JoteraJ/do-an-chuyen-nganh-meshdrone/docs/nhatkylamviec/nhat-ky_2026-09-26_den_2026-09-27.md

# Nhật ký làm việc — 26/09/2026 → 27/09/2026

Đồ án: Mạng WiFi Mesh kết nối Drone/Robot (Đề tài 14)
Folder kiểm tra: `D:\DOAN_CHUYENNGANH_MESH`
Cách lập: so thời gian sửa file trong folder + đọc lịch sử git cục bộ (`.git`), so sánh commit `4a47520` (18/09) với `5bc8f30` (27/09) bằng `git diff`. Chỉ đọc, không ghi gì vào folder.

---

## 1. Tóm tắt nhanh

Trong 2 ngày có **5 file code thay đổi thật** (firmware Root, firmware Leaf/Camera, 2 file `mesh_config.h`, dashboard) — tổng **+1332 / −261 dòng**. Tất cả được gộp vào 1 commit và đã push lên GitHub (`origin/main = 5bc8f30`). Ngoài ra có 1 sửa `.gitignore` **chưa commit**.

Chủ đề chính: **chuẩn bị cho chạy nhiều Leaf cùng lúc (3 Leaf)** — Root ghép được nhiều frame song song, Leaf gửi thẳng về Root thay vì broadcast, và dashboard có tab đo/so sánh 1–2–3 Leaf.

| Thời điểm | File | Loại thay đổi |
|---|---|---|
| 26/09 16:05 | `thuattoan/node_camera/mesh_config.h` | Sửa (+beacon, đổi hằng reassembly) |
| 26/09 16:07 | `thuattoan/node_root/node_root.ino` | Sửa (4 slot, supersede, beacon) |
| 26/09 16:08 | `thuattoan/node_camera/node_camera.ino` | Sửa (sendSingle, học root_id) |
| 26/09 16:09 | `thuattoan/node_root/mesh_config.h` | Sửa (4 slot × 24KB, beacon) |
| 26/09 19:31 | `thuattoan/middleware/public/dashboard.html` | Viết lại gần hết (345 → 1274 dòng) |
| 27/09 21:16–21:17 | git: pull → commit → amend ×2 → push | Xem mục 4 |
| 27/09 21:17 | `prompt_bringup_3_leaf_camera_node.md` | Chỉ đổi thời gian sửa, **nội dung không đổi** (chỉ khác ký tự xuống dòng CRLF) |
| 27/09 22:03 | `.gitignore` | Sửa, **chưa commit** |

Các thư mục còn lại (`baocao/`, `nhatkylamviec/`, `tài liệu/`, `code esp32/`, `thuattoan/shared/`, `thuattoan/esp_idf_migration/`, `middleware/server.js`…) **không có thay đổi** trong khoảng thời gian này.

---

## 2. Firmware — chi tiết thay đổi

### 2.1. Root Node (`node_root.ino` + `node_root/mesh_config.h`)

**Bộ nhớ ghép ảnh (reassembly):**
- `MAX_CONCURRENT_FRAMES`: **1 → 4** slot.
- `MAX_FRAME_SIZE`: **65536 → 24576** byte (24KB); `MAX_CHUNKS_PER_FRAME`: **64 → 24**.
- Tổng buffer: 4 × 24KB = **96KB SRAM** (trước là 1 × 64KB). Ghi chú trong code: Root là ESP32-WROOM-32D **không có PSRAM**, còn khoảng ~120KB SRAM khả dụng.
- Lý do ghi trong code: số slot phải ≥ số Leaf gửi đồng thời + 1, nếu không chunk của Leaf này sẽ đẩy frame đang ghép dở của Leaf kia ra (eviction chéo → drop cao). 4 slot đủ cho 3 Leaf.
- Thêm `#error` kiểm tra lúc biên dịch: `MAX_CHUNKS_PER_FRAME × MAX_CHUNK_PAYLOAD` phải ≥ `MAX_FRAME_SIZE`.
- `REASSEMBLY_TIMEOUT_MS`: **5000 → 2000 ms** (1 frame gửi xong ~0,5s, chờ 5s chỉ giữ slot vô ích).

**Logic ghép mới — "Supersede":**
- Khi chunk của một frame MỚI từ cùng node tới, Root hủy ngay mọi slot đang ghép dở của CÙNG node nhưng khác `frame_id` (vì Leaf gửi tuần tự qua TCP, frame cũ chắc chắn không hoàn thành nữa). Có log `[ASM] SUPERSEDE` và tăng `frames_dropped`.
- Hàm chọn slot cũ nhất để evict: thêm kiểm tra `assemblies[i].active` cho an toàn.

**Beacon Root:**
- Trong `loop()`, cứ `ROOT_BEACON_INTERVAL_MS = 2000 ms` Root phát `mesh.sendBroadcast("#ROOT")`.
- `receivedCallback()` bỏ qua message bắt đầu bằng `#ROOT`. Chọn ký tự `#` vì không thuộc bảng mã Base64 → không nhầm với chunk.

**Giảm log:**
- `mesh.setDebugMsgTypes(ERROR | CONNECTION)` → **`ERROR`** (log painlessMesh chèn vào luồng nhị phân UART 921600 làm middleware phải bỏ byte).
- Thêm cờ `DEBUG_ASM_VERBOSE = 0` để tắt log "bắt đầu ghép / hoàn thành" khi đo hiệu năng.

**Cập nhật chú thích:** thêm cảnh báo — nếu bật lại luồng HTTP MJPEG với nhiều Leaf thì `latest_frame` đang trỏ thẳng vào assembly buffer có thể bị ghi đè; hiện chấp nhận vì HTTP đang tắt.

### 2.2. Leaf / Camera Node (`node_camera.ino` + `node_camera/mesh_config.h`)

**Gửi thẳng về Root thay vì broadcast:**
- Thêm biến `root_id` (mặc định `ROOT_NODE_ID_OVERRIDE = 0` = tự học).
- `receivedCallback()` nay lắng nghe beacon `#ROOT`, gán `root_id = from` và in `[MESH] Root ID = ...`.
- Gửi chunk: `root_id != 0` → `mesh.sendSingle(root_id, ...)`; chưa biết Root → vẫn `sendBroadcast()` làm fallback.
- `changedConnectionCallback()`: nếu Root biến khỏi danh sách node (ví dụ rút nguồn) → reset `root_id` để học lại qua beacon.

**Tiết kiệm tài nguyên:**
- Bước 0 mới trong `capture_and_send()`: nếu chưa biết Root **và** mesh không có node nào → bỏ qua, không chụp (tránh giữ frame buffer duy nhất `CAM_FB_COUNT = 1`).

**Thống kê/log:**
- Thêm bộ đếm `chunks_send_fail`; dòng `[STAT]` in thêm `ChunksFail` và `RootID`.
- Cờ `DEBUG_CAM_VERBOSE = 0` tắt log từng frame; `setDebugMsgTypes` cũng hạ về `ERROR`.

**`mesh_config.h` của Leaf:** các hằng reassembly đổi **khớp với Root** (timeout 2000 ms, 24KB, 24 chunk) để Leaf tự bỏ frame > 24KB trước khi gửi; thêm cùng khối cấu hình beacon (mục 9).

---

## 3. Dashboard (`middleware/public/dashboard.html`)

Viết lại gần như toàn bộ: **345 → 1274 dòng** (diff +1134/−205). Vẫn giữ stack cũ (React 18 + Babel + Tailwind từ CDN, Socket.IO) và cùng 5 sự kiện: `connect`, `disconnect`, `status`, `telemetry`, `frame`.

**Thay đổi chính:**
- Đổi tên hiển thị: "SmartNetworkX" → **"Dashboard Mesh Drone"**; giao diện mới (tông tối zinc, header có badge trạng thái Middleware / Root UART và số LEAF).
- **2 tab:** `Live` và **`So sánh 1/2/3 leaf`**.
- Tab So sánh: mỗi lần nhận telemetry tính tốc độ thay đổi của `frames_ok`, `frames_drop`, `chunks` + số byte JPEG thật nhận qua sự kiện `frame`, rồi xếp mẫu vào nhóm theo `node_count` Root báo. 7 chỉ số: FPS tổng, FPS/leaf, thông lượng ảnh (KB/s), tỉ lệ drop (%), chunk/s tại Root, kích thước frame TB, heap trống tại Root; thêm chỉ số **thời gian self-healing** lấy từ `last_self_heal_ms`.
- Có nút ghi/tạm dừng, reset, biểu đồ cột so sánh, timeline, sparkline, bảng tổng hợp.
- Số liệu tích lũy lưu trong `localStorage` (khóa `meshDashCompare.v1`) → đo lần lượt 1 → 2 → 3 Leaf rồi so sánh, không mất khi tải lại trang.
- Nguyên tắc ghi trong code: **không có dữ liệu giả lập** — chưa có thì hiện "chưa có dữ liệu".
- Hằng tự điền: `HEAP_TOTAL_BYTES`, `PSRAM_TOTAL_BYTES`, `FPS_TARGET` đang để `null`.

Đã đối chiếu: các trường dashboard đọc (`frames_ok`, `frames_drop`, `chunks`, `heap_free`, `psram_free`, `node_count`, `node_ids`, `last_self_heal_ms`) **đều có** trong JSON telemetry mà `node_root.ino` đang gửi.

---

## 4. Git — những gì đã xảy ra tối 27/09

1. **21:16:47** `git pull` — không có gì mới (remote vẫn ở `4a47520`).
2. **21:16:48** commit `b6d75b6` "Them log 2026-09-27" — commit này **vô tình xóa** `prompt_bringup_3_leaf_camera_node.md` (−107 dòng).
3. **21:17:26** `commit --amend` → `5b56776`: thêm lại file prompt (nội dung giống hệt bản cũ).
4. **21:17:33** `commit --amend` lần 2 → `5bc8f30`, đổi message thành **"Cap nhat node_root, node_camera, mesh_config va dashboard"**.
5. **21:17:42** `git push` → GitHub `origin/main = 5bc8f30`.

Kết quả cuối: commit đã push chứa đúng 5 file code ở mục 2–3, file prompt được giữ nguyên.

---

## 5. Việc còn dở / cần lưu ý

1. **`.gitignore` sửa lúc 22:03 chưa commit.** Bản trong git đang ghi sai đường dẫn `thuattoancatanh/middleware/node_modules/` (tên thư mục cũ); bản mới sửa thành `thuattoan/middleware/node_modules/` và thêm `desktop.ini`.
2. **`node_modules` vẫn đang nằm trong git (1206 file).** Sửa `.gitignore` không tự gỡ file đã được theo dõi — cần chạy thêm `git rm -r --cached thuattoan/middleware/node_modules` rồi commit, repo mới hết chứa `node_modules`.
3. **Chưa có file nhật ký mới trong `nhatkylamviec/`** — file gần nhất vẫn là bản 17/09 (commit đầu tiên tên "Them log 2026-09-27" nhưng không thêm file log nào).
4. **Chưa có bằng chứng đã nạp và chạy thử firmware mới trên board** (không có file log/kết quả đo mới trong folder). Khi nạp nên kiểm tra:
   - `heap_free` của Root sau khi khởi động, vì buffer ghép tăng từ 64KB lên 96KB SRAM.
   - Leaf in được `[MESH] Root ID = ...` trong vài giây đầu, và `ChunksFail` trong dòng `[STAT]` gần 0.
   - Log `[ASM] SUPERSEDE` và tỉ lệ drop khi chạy 2–3 Leaf cùng lúc.
5. Dashboard xếp nhóm theo `node_count` = tổng số node trong mesh (trừ Root). Hiện đúng vì mọi node đều là Leaf camera; nếu sau này thêm Parent node không có camera thì số "leaf" sẽ bị đếm dư.
6. Nếu đo nhiều đợt, nhớ bấm reset tab So sánh trước mỗi đợt đo mới, vì số liệu cũ còn lưu trong `localStorage` của trình duyệt.
