JoteraJ/do-an-chuyen-nganh-meshdrone/baocao/DoAn_WiFiMesh_LaTeX/chapters/chuong1.tex

% ================= CHƯƠNG 1 =================
\chapter{GIỚI THIỆU ĐỀ TÀI}\label{chap:1}

Chương này trình bày bối cảnh và lý do lựa chọn đề tài, mục tiêu, nhiệm vụ, đối tượng và phạm vi nghiên cứu, phương pháp thực hiện và bố cục của báo cáo. Các yêu cầu của đề tài được diễn giải thành chức năng, thông số kỹ thuật và giới hạn cụ thể để làm căn cứ đánh giá ở các chương sau. Nội dung của chương là cơ sở để các chương tiếp theo đi vào lý thuyết, thiết kế và kết quả thực nghiệm của hệ thống.

\section{Đặt vấn đề}\label{sec:1.1}

Trong nhiều hệ thống drone và robot hiện nay, các thiết bị kết nối với trạm điều khiển theo mô hình WiFi hình sao (star topology), tức là mọi thiết bị đều phải liên kết trực tiếp với một bộ định tuyến hoặc điểm truy cập trung tâm. Khi thiết bị di chuyển ra xa vùng phủ của bộ định tuyến, hoặc khi bộ định tuyến gặp sự cố, liên kết của thiết bị với trạm bị gián đoạn. Giải pháp thay thế bằng mạng di động 4G đòi hỏi thẻ SIM (Subscriber Identity Module) và hạ tầng nhà mạng, vốn thường không có ở những nơi drone và robot cần làm việc như vùng thiên tai, hầm mỏ hay khu vực rừng núi.

Mạng mesh không dây khắc phục hạn chế này bằng cách cho mỗi node vừa gửi dữ liệu của chính nó vừa chuyển tiếp dữ liệu cho các node lân cận. Nhờ đó, drone hoặc robot nằm ngoài tầm phát trực tiếp của trạm vẫn gửi được dữ liệu qua một chuỗi liên kết đa chặng (multi-hop) \citep{akyildiz2005,bekmezci2013}. Các vi điều khiển tự tạo thành một mạng vô tuyến cục bộ riêng, không cần SIM và không cần Internet. Giả sử một robot hoạt động trong tòa nhà và tường chắn tín hiệu trực tiếp tới trạm; robot vẫn gửi được ảnh nếu có một node trung gian đặt ở hành lang nằm trong tầm phát của cả robot và trạm.

Bài toán đặt ra hai thách thức kỹ thuật chính. Thách thức thứ nhất là định tuyến dữ liệu qua nhiều chặng trong khi topology của mạng thay đổi theo vị trí của các node. Thách thức thứ hai là truyền dữ liệu ảnh có kích thước lớn qua các liên kết vô tuyến có băng thông hạn chế, trong khi mỗi bản tin của thư viện mesh trên ESP32 chỉ mang được khoảng 1400 byte \citep{painlessmesh}.

Đề tài giải quyết bài toán bằng một mạng WiFi Mesh dùng vi điều khiển ESP32 giá thấp và thư viện painlessMesh. Các node lá (Leaf) mang camera đóng vai trò drone hoặc robot thu thập hình ảnh, còn node gốc (Root) nối với máy tính đóng vai trò trạm giám sát. Ảnh định dạng JPEG (Joint Photographic Experts Group) được chia thành nhiều phần nhỏ, truyền qua mạng mesh, ghép lại tại Root và hiển thị trên một giao diện web cùng với các thông số chất lượng mạng.

Về ý nghĩa thực tiễn, đề tài tạo ra một mô hình thử nghiệm giá thấp để đánh giá khả năng truyền ảnh qua mạng mesh trước khi đưa hệ thống lên drone hoặc robot thật. Mô hình phục vụ người phát triển các hệ thống này: thay vì chỉ dựa vào thông số của nhà sản xuất, người phát triển có thể đo trực tiếp thông lượng, số khung trên giây, tỉ lệ hủy khung, độ trễ và thời gian tự phục hồi trên phần cứng thật. Các phép đo ở Chương 4 cho thấy cách mô hình này giúp xác định nút thắt của hệ thống, cụ thể là số vùng đệm ghép ảnh và tải ghi dữ liệu qua giao tiếp nối tiếp UART (Universal Asynchronous Receiver-Transmitter) tại Root.

\section{Mục tiêu của đề tài}\label{sec:1.2}

Mục tiêu của đề tài được xác định ở hai mức. Mục tiêu tổng quát định hướng cho toàn bộ quá trình thực hiện, còn các mục tiêu cụ thể được dùng làm tiêu chí đánh giá kết quả. Các tiêu chí này được định nghĩa thành công thức ở mục~\ref{sec:2.6} và được đo ở Chương 4.

\subsection{Mục tiêu tổng quát}

Mục tiêu tổng quát của đề tài là thiết kế, thi công và đánh giá một mạng WiFi Mesh nhiều node có khả năng truyền ảnh từ các node di động về trạm giám sát theo thời gian thực. Bên cạnh chức năng truyền ảnh, hệ thống phải cung cấp công cụ đo lường để đánh giá chất lượng mạng ngay trong quá trình hoạt động. Các node trong đề tài mô phỏng drone và robot, nên mục tiêu tập trung vào khối truyền thông chứ không vào khối bay hay cơ khí.

\subsection{Mục tiêu cụ thể}

Vì đây là đồ án thuộc chuyên ngành Điện tử – Viễn thông, trọng tâm đánh giá là chất lượng mạng vô tuyến chứ không phải khả năng bay hay cơ khí của drone. Đề tài đặt ra ba tiêu chí đánh giá chính. Tiêu chí thứ nhất là thông lượng (throughput), gồm giá trị thông lượng và mức suy giảm của nó khi dữ liệu đi qua nhiều hop. Tiêu chí thứ hai là độ trễ (latency), tức khoảng thời gian từ lúc chụp ảnh đến lúc ảnh được ghép xong tại trạm giám sát. Tiêu chí thứ ba là thời gian tự phục hồi (self-healing), tức khoảng thời gian mạng khôi phục đường truyền khi một node trung gian mất nguồn hoặc ra khỏi vùng phủ sóng.

\section{Nhiệm vụ của đề tài}\label{sec:1.3}

Để đạt được các mục tiêu trên, yêu cầu của đề tài được diễn giải thành sáu nhóm nhiệm vụ, bao phủ từ nghiên cứu nền tảng phần mềm, phần cứng, cơ chế truyền ảnh, phần mềm trên máy tính đến kịch bản thử nghiệm. Với mỗi nhóm, Bảng~\ref{tab:1.1} nêu chức năng cần đạt, thông số kỹ thuật được chọn và giới hạn trong phạm vi đồ án. Các nhóm nhiệm vụ này cũng quyết định cấu trúc của Chương 3 và Chương 4.

\begin{table}[!htbp]
\centering
\caption{Diễn giải các nhóm nhiệm vụ của đề tài}\label{tab:1.1}
{\fontsize{12}{14.5}\selectfont\renewcommand{\arraystretch}{1.25}
\begin{tabular}{|C{1.10cm}|L{3.40cm}|L{9.30cm}|}
\hline
\textbf{STT} & \textbf{Nhóm nhiệm vụ} & \textbf{Chức năng, thông số và giới hạn} \\
\hline
1 & Nền tảng phần mềm & Tìm hiểu cơ chế tác vụ của FreeRTOS và cách painlessMesh tự tổ chức mạng cây; thiết kế mô hình một Root nhận dữ liệu từ nhiều Leaf. \\
\hline
2 & Phần cứng và nguồn & Một Root ESP32 DevKitC cấp nguồn qua cổng USB (Universal Serial Bus); ba Leaf ESP32-CAM OV3660, mỗi Leaf dùng pin 18650 và module tăng áp 5 V; đo dòng tiêu thụ và đánh giá độ ổn định khi truyền. \\
\hline
3 & Truyền ảnh qua mesh & Chia ảnh JPEG thành chunk tối đa 1024 byte kèm header 16 byte; Root ghép tối đa bốn khung song song và hủy khung thiếu chunk sau 2 giây; chưa có cơ chế gửi lại. \\
\hline
4 & Thu nhận dữ liệu trên máy tính & Root gửi khung nhị phân có mã kiểm tra CRC16 (Cyclic Redundancy Check) qua UART 921600 bps; middleware Node.js phát dữ liệu tới trình duyệt bằng Socket.IO trên nền WebSocket. \\
\hline
5 & Giao diện giám sát & Web Dashboard hiển thị ảnh từng Leaf, topology, cường độ tín hiệu RSSI (Received Signal Strength Indicator), độ trễ, thông lượng, số khung trên giây, tỉ lệ hủy khung và xuất dữ liệu ra tệp CSV (Comma-Separated Values). \\
\hline
6 & Kịch bản thử nghiệm & Thay đổi số Leaf từ một đến ba, số hop và tải dữ liệu qua chu kỳ chụp 300 ms hoặc 600 ms; đánh giá thông lượng, độ trễ, tỉ lệ hủy khung, khả năng tự phục hồi và khả năng mở rộng. \\
\hline
\end{tabular}}
\end{table}

\section{Đối tượng và phạm vi nghiên cứu}

Mục này xác định đối tượng mà đề tài tập trung nghiên cứu và giới hạn phạm vi thực hiện. Đối tượng và phạm vi này là cơ sở để xây dựng các kịch bản thử nghiệm được trình bày ở Chương 4. Những nội dung nằm ngoài phạm vi được nêu rõ để tránh mở rộng nhận xét vượt quá điều kiện đã thử nghiệm.

\subsection{Đối tượng nghiên cứu}

Đối tượng nghiên cứu là mạng mesh WiFi tạo bởi các vi điều khiển ESP32 sử dụng thư viện painlessMesh, cùng cơ chế truyền ảnh JPEG qua mạng này. Phần cứng thử nghiệm gồm một Root dùng board ESP32-WROOM-32D DevKitC và ba Leaf dùng board ESP32-CAM với camera OV3660. Các node sử dụng anten mạch in PCB (Printed Circuit Board) tích hợp sẵn trên board, không sử dụng anten rời.

\subsection{Phạm vi nghiên cứu}

Đề tài không chế tạo khung drone hay robot. Chuyển động của drone được mô phỏng bằng cách cầm tay hoặc đặt các node ở những vị trí cố định khác nhau trên mặt đất, không sử dụng xe điều khiển từ xa. Ba Leaf có cấu hình phần cứng giống nhau; vai trò chuyển tiếp không gắn với một phần cứng riêng mà do mạng tự hình thành tùy theo vị trí và cường độ tín hiệu tại thời điểm thử nghiệm. Với một Root và ba Leaf, mạng có thể tạo chuỗi tối đa ba hop để đo thông lượng và độ trễ theo số hop.

\section{Phương pháp thực hiện}

Đề tài được thực hiện theo phương pháp lặp. Sau khi nghiên cứu cơ sở lý thuyết, đề tài xây dựng firmware và phần mềm, rồi đưa từng board vào hoạt động (bring-up). Tiếp theo, hệ thống được thử nghiệm với số node tăng dần và số liệu được thu thập bằng Web Dashboard; mỗi khi xảy ra lỗi, nguyên nhân được chẩn đoán, khắc phục và hệ thống được đo lại.

Về công cụ, firmware được phát triển trên môi trường lập trình Arduino IDE (Integrated Development Environment) 2.3.10 với gói board esp32 của Espressif phiên bản 2.0.17, được hạ từ phiên bản 3.3.11 theo khuyến nghị của painlessMesh, và thư viện Alteriom/painlessMesh 2.0.3. Phần mềm trên máy tính sử dụng Node.js, giao diện giám sát sử dụng React và Tailwind CSS. Mã nguồn được quản lý bằng Git trên GitHub.

Trong quá trình thực hiện, đề tài từng thử nghiệm song song một phiên bản dùng giao diện lập trình API (Application Programming Interface) ESP-WIFI-MESH chính thức của Espressif trên nền ESP-IDF (Espressif IoT Development Framework). Ngày 29/09/2026, đề tài chốt sử dụng painlessMesh làm phiên bản chính thức vì danh sách nhiệm vụ đã xác định rõ giao thức này. Phiên bản ESP-IDF được giữ lại và đưa vào hướng phát triển ở Chương 5.

\section{Bố cục báo cáo}\label{sec:1.6}

Báo cáo được tổ chức thành năm chương, đi từ yêu cầu của đề tài tới lý thuyết, thiết kế, kết quả đo và kết luận. Chương 1 giới thiệu bài toán, mục tiêu, nhiệm vụ, đối tượng, phạm vi và phương pháp thực hiện. Chương 2 trình bày cơ sở lý thuyết về mạng mesh không dây, các giao thức định tuyến, mạng ad-hoc cho thiết bị bay, ESP-WIFI-MESH và painlessMesh, FreeRTOS trên ESP32, nền tảng phần cứng và các chỉ số đánh giá hiệu năng mạng.

Dựa trên các cơ sở đó, Chương 3 trình bày thiết kế hệ thống theo thứ tự từ sơ đồ khối tổng thể tới phần cứng các node, firmware trên mạng mesh và phần mềm trên máy tính gồm giao thức UART, middleware và Web Dashboard. Chương 4 trình bày quá trình thử nghiệm, kết quả đo và các nhận xét rút ra từ số liệu. Cuối cùng, Chương 5 tổng kết các kết quả đạt được, các hạn chế và hướng phát triển của đề tài.

\section{Kết luận chương}

Chương 1 đã xác định bài toán liên lạc cho drone và robot khi không có hạ tầng mạng cố định và đề xuất hướng giải quyết bằng mạng WiFi Mesh dùng ESP32. Các yêu cầu của đề tài đã được diễn giải thành sáu nhóm nhiệm vụ với thông số và giới hạn cụ thể, cùng phạm vi thử nghiệm trên mặt đất với một Root và ba Leaf. Chương 2 tiếp theo trình bày cơ sở lý thuyết làm nền cho thiết kế và đánh giá hệ thống.
