JoteraJ/do-an-chuyen-nganh-meshdrone/baocao/DoAn_WiFiMesh_LaTeX/frontmatter/biachinh.tex

% ================= BÌA CHÍNH =================
\begin{titlepage}
\centering
\fontsize{14}{17}\selectfont
TỔNG LIÊN ĐOÀN LAO ĐỘNG VIỆT NAM\\
\textbf{TRƯỜNG ĐẠI HỌC TÔN ĐỨC THẮNG}\\
\textbf{KHOA ĐIỆN – ĐIỆN TỬ}\\[1.2cm]
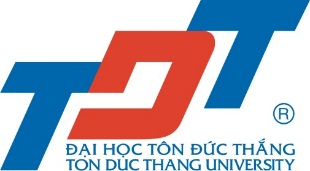
[picture p1: baocao/DoAn_WiFiMesh_LaTeX/figures/logo_tdtu.jpg]
\\[1.5cm]
\textbf{\tensinhvien}\\[2.2cm]
{\fontsize{24}{30}\selectfont\bfseries \tendetai\par}
\vspace{2.2cm}
{\fontsize{22}{28}\selectfont\bfseries \loaidoan\\[0.3cm] \nganh\par}
\vfill
\textbf{THÀNH PHỐ HỒ CHÍ MINH, NĂM \namthuchien}
\end{titlepage}
