JoteraJ/do-an-chuyen-nganh-meshdrone/baocao/DoAn_WiFiMesh_LaTeX/frontmatter/biaphu.tex

% ================= BÌA PHỤ =================
\begin{titlepage}
\centering
\fontsize{14}{17}\selectfont
TỔNG LIÊN ĐOÀN LAO ĐỘNG VIỆT NAM\\
\textbf{TRƯỜNG ĐẠI HỌC TÔN ĐỨC THẮNG}\\
\textbf{KHOA ĐIỆN – ĐIỆN TỬ}\\[1.2cm]
\\[1.5cm]
\textbf{\tensinhvien}\\[0.3cm]
MSSV: \mssv\\[1.9cm]
{\fontsize{22}{28}\selectfont\bfseries \tendetaidongmot\\ \tendetaidonghai\par}
\vspace{1.8cm}
{\fontsize{20}{26}\selectfont\bfseries \loaidoan\\[0.3cm] \nganh\par}
\vspace{1.5cm}
Người hướng dẫn\\
\textbf{\gvhd}
\vfill
\textbf{THÀNH PHỐ HỒ CHÍ MINH, NĂM \namthuchien}
\end{titlepage}
\setcounter{page}{3}
