JoteraJ/do-an-chuyen-nganh-meshdrone/baocao/DoAn_WiFiMesh_LaTeX/frontmatter/loicamon.tex

% ================= LỜI CẢM ƠN =================
\chapter*{LỜI CẢM ƠN}
Tôi xin chân thành cảm ơn \gvhd{} đã tận tình hướng dẫn, góp ý và định hướng cho tôi trong suốt quá trình thực hiện đồ án. Tôi cũng xin cảm ơn quý thầy cô Khoa Điện – Điện tử, Trường Đại học Tôn Đức Thắng đã truyền đạt những kiến thức nền tảng về điện tử, viễn thông và mạng máy tính, giúp tôi có cơ sở để hoàn thành đề tài này. Cuối cùng, tôi xin cảm ơn gia đình và bạn bè đã luôn động viên, hỗ trợ tôi trong thời gian qua.

\vspace{1cm}
\hfill\begin{minipage}{0.55\textwidth}\centering
\textit{\ngayky}\\
\textit{Tác giả}\\[2cm]
\textit{\tensinhvienthuong}
\end{minipage}
