JoteraJ/do-an-chuyen-nganh-meshdrone/baocao/DoAn_WiFiMesh_LaTeX/frontmatter/viettat.tex

% ================= DANH MỤC CHỮ VIẾT TẮT =================
% Sắp theo thứ tự ABC; gồm cả các chữ viết tắt xuất hiện ở Chương 4.
\chapter*{DANH MỤC CÁC CHỮ VIẾT TẮT}
\phantomsection\addcontentsline{toc}{chapter}{DANH MỤC CÁC CHỮ VIẾT TẮT}
\begin{longtable}{@{}p{3.2cm}p{11.8cm}@{}}
AGPS & Assisted Global Positioning System \\
AODV & Ad hoc On-Demand Distance Vector \\
AP & Access Point \\
API & Application Programming Interface \\
B.A.T.M.A.N & Better Approach To Mobile Ad-hoc Networking \\
COM & Communication port \\
CPU & Central Processing Unit \\
CRC & Cyclic Redundancy Check \\
CSMA/CA & Carrier Sense Multiple Access with Collision Avoidance \\
CSV & Comma-Separated Values \\
DC & Direct Current \\
DGPS & Differential Global Positioning System \\
DSDV & Destination-Sequenced Distance Vector \\
DSR & Dynamic Source Routing \\
ELP & Echo Location Protocol \\
ESP-IDF & Espressif IoT Development Framework \\
FANET & Flying Ad-hoc Network \\
FPS & Frames Per Second \\
GPS & Global Positioning System \\
GPSR & Greedy Perimeter Stateless Routing \\
ID & Identifier \\
IDE & Integrated Development Environment \\
IMU & Inertial Measurement Unit \\
IoT & Internet of Things \\
IP & Internet Protocol \\
IWDT & Interrupt Watchdog Timer \\
JPEG & Joint Photographic Experts Group \\
JSON & JavaScript Object Notation \\
LoS & Line of Sight \\
LRU & Least Recently Used \\
lwIP & Lightweight IP \\
MANET & Mobile Ad-hoc Network \\
NACK & Negative Acknowledgement \\
OGM & Originator Message \\
OLSR & Optimized Link State Routing \\
OTA & Over-The-Air \\
PCB & Printed Circuit Board \\
PSRAM & Pseudo-Static Random Access Memory \\
RFC & Request for Comments \\
RSSI & Received Signal Strength Indicator \\
RTOS & Real-Time Operating System \\
SIM & Subscriber Identity Module \\
SMP & Symmetric Multiprocessing \\
SoC & System on Chip \\
SPI & Serial Peripheral Interface \\
SPIFFS & SPI Flash File System \\
SRAM & Static Random Access Memory \\
STA & Station \\
STT & Số thứ tự \\
SVG & Scalable Vector Graphics \\
TBRPF & Topology Broadcast based on Reverse-Path Forwarding \\
TCP & Transmission Control Protocol \\
TQ & Transmit Quality \\
TWDT & Task Watchdog Timer \\
TX & Transmit \\
UART & Universal Asynchronous Receiver-Transmitter \\
UAV & Unmanned Aerial Vehicle \\
USB & Universal Serial Bus \\
UTC & Coordinated Universal Time \\
UWB & Ultra-Wideband \\
VANET & Vehicular Ad-hoc Network \\
WMN & Wireless Mesh Network \\
\end{longtable}
