JoteraJ/do-an-chuyen-nganh-meshdrone/baocao/tiến độ/Bao_cao_50_WiFi_Mesh.pptx

BÁO CÁO TIẾN ĐỘ 50%

Mạng WiFi Mesh
cho Drone / Robot

Truyền ảnh ESP32-CAM qua mesh đa chặng — Đề tài 14

Nguyễn Dương Hiếu

Notes: Mở đầu: đồ án xây mạng WiFi mesh tự tổ chức giữa các ESP32-CAM, ảnh đi đa chặng về Root rồi lên PC. Nguồn: claude_trang-thai-hien-tai.md.

## Slide 2

Mục tiêu: 3 tiêu chí đánh giá

Throughput

Lượng ảnh qua mesh
theo số node / số hop

Latency

Độ trễ từ lúc chụp
đến lúc tới Root

Self-healing

Thời gian mạng tự
phục hồi khi mất node

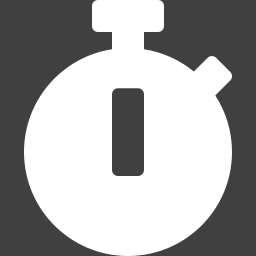
[picture p3: figure]

Yêu cầu đề bài: ESP-Mesh hoặc BATMAN-adv

Notes: 3 tiêu chí hội đồng chấm: throughput, latency, self-healing — đo trên mesh nội bộ (2026-09-13_middleware-test-wifi-debug.md). Đề bài: "ESP-Mesh hoặc BATMAN-adv"; BATMAN-adv là module kernel Linux nên không chạy trên ESP32 (claude_migration-esp-wifi-mesh.md).

## Slide 3

Sơ đồ khối hệ thống

Leaf ×3

ESP32-CAM
OV3660

Root

ESP32
WROOM-32D

Middleware

Node.js
PC

Dashboard

Web
localhost:3000


WiFi Mesh


UART
921600


Socket.IO


Lớp 1 · Mesh không dây

Lớp 2 · UART nhị phân + CRC16

Lớp 3 · Middleware + Dashboard

Notes: Kiến trúc 3 lớp: Leaf → mesh → Root → UART 921600 → middleware Node.js → Socket.IO → dashboard (claude_trang-thai-hien-tai.md; claude_2026-09-18_bao-cao-tien-do-va-kiem-tra-source-code.md hình 1). Root: ESP32-32D DevKitC, CP2102, không PSRAM (2026-09-12_root-node-bringup.md). Leaf: ESP32-CAM OV3660, CH340 (2026-09-14_leaf-bringup-mesh-fix.md). Thư viện: Alteriom/painlessMesh.

## Slide 4

Cấu trúc mạng: cây mesh động

ROOT

Layer 0

Mỗi node: AP + STA
cùng lúc

Parent tự bầu
theo RSSI

Layer 1

Leaf A

Leaf B

B tự làm Parent
(relay cho C)

Đường dự phòng
khi B mất

Tối đa 3 hop
với 3 Leaf

Layer 2

Leaf C

Notes: ESP32 vừa là station nối lên cha vừa là AP cho con → cây nhiều lớp (tài_liệu, Phần 3.1). Không có node Parent riêng về phần cứng; vai trò tự bầu theo RSSI, 3 node di động + Root dựng được chuỗi tối đa 3 hop (claude_trang-thai-hien-tai.md). Node cha hỏng → con tự chọn cha mới, có thể thêm 1 lớp (tài_liệu, Phần 3.2). Lưu ý: hình minh họa nguyên lý; test 17/09 thực tế 2 Leaf nối trực tiếp 1 hop.

## Slide 5

Lưu đồ Leaf: chụp và gửi ảnh

Mesh có
node?

Ảnh
> 24 KB?

Bắt đầu

Có

Chụp JPEG

Có

Bỏ khung

Không

Chờ, không chụp

Không

Đã biết
Root ID?

Cắt chunk 1024 B
+ header 12 B

sendBroadcast()

Không

Mã hóa Base64

Có

sendSingle(Root)

↻ lặp lại cho khung tiếp theo

Root ID học từ beacon
“#ROOT” mỗi 2 giây

Notes: Lưu đồ capture_and_send() bản 26/09: bỏ qua nếu chưa có mesh; khung > 24KB bị bỏ; chunk 1024B + header 12B; Base64 vì painlessMesh chỉ nhận String; sendSingle tới root_id học qua beacon #ROOT mỗi 2000ms, chưa biết Root thì sendBroadcast (nhat-ky_2026-09-26_den_2026-09-27.md; claude_migration-esp-wifi-mesh.md; claude_trang-thai-hien-tai.md).

## Slide 6

Lưu đồ Root: ghép ảnh từ nhiều Leaf

Beacon
#ROOT?

Khung mới
cùng node?

Nhận chunk

Không

Tìm slot theo
(node, frame)

Có

Hủy khung
cũ

Có

Bỏ qua

Không

Gửi ảnh lên PC
qua UART

Đủ chunk?

Ghi chunk
+ đánh bitmap

Có

Không

Hủy, drop +1

Có

Quá 2 s?

Không

Chờ chunk tiếp

4 slot
× 24 KB

Notes: Root bản 26/09: bỏ qua message #ROOT; 4 slot ghép song song (4×24KB = 96KB SRAM); supersede: khung mới cùng node → hủy khung cũ đang ghép dở; bitmap đánh dấu chunk; timeout 2000ms; ghép xong gửi khung UART TYPE 0x01 (nhat-ky_2026-09-26_den_2026-09-27.md; claude_2026-09-18_bao-cao-tien-do-va-kiem-tra-source-code.md). Code đã push, chưa nạp board.

## Slide 7

Cấu trúc gói tin

Gói chunk trên mesh

Header
12 B

ID node · ID khung · …

Payload JPEG ≤ 1024 B

→ mã hóa Base64 rồi gửi qua painlessMesh

Khung UART Root → PC

MAGIC

TYPE

LEN

DATA

CRC16

TYPE 0x01 = ảnh đã ghép · telemetry JSON mỗi 2 s

Notes: Chunk 1024B + header 12B (claude_trang-thai-hien-tai.md; claude_2026-09-18...). Base64 vì painlessMesh chỉ nhận String (claude_migration-esp-wifi-mesh.md). Khung UART MAGIC+TYPE+LEN+CRC16, TYPE 0x01 = ảnh đã ghép, telemetry JSON mỗi 2s (claude_trang-thai-hien-tai.md; 2026-09-12_root-node-bringup.md). Kích thước từng trường của khung UART: không tìm thấy trong tài liệu hiện có.

## Slide 8

Làm sao biết node đang ở trong mesh?

Kiểm chứng qua 4 tầng, từ node đến màn hình

1

2

3

4

Leaf

Root ID = …

Root

node_ids có ID Leaf

PC /status

ảnh từ nodeId Leaf

Dashboard

ảnh “vừa xong”

Ảnh vẫn tới PC
= dữ liệu đã đi qua mesh


Leaf chỉ cắm nguồn

không dây dữ liệu nối PC

Notes: Trả lời: 1) Serial Leaf: [MESH] Node ID, Found 1 nodes ESP32_MESH_VIDEO -57dBm, [MESH] Root ID = ..., [STAT] ChunksFail ~0 (2026-09-14_leaf-bringup-mesh-fix.md; nhat-ky_2026-09-26_den_2026-09-27.md). 2) Telemetry Root mỗi 2s: node_count, node_ids từ bảng node mesh. 3) /status: latestFrameMeta.nodeId, framesBadCrc ~0. 4) Dashboard: badge LEAF, ảnh "vừa xong"; cẩn thận ảnh cũ kèm "X giây trước". Bằng chứng mạnh nhất: Leaf chỉ cấp nguồn vẫn gửi ảnh được — đã xác nhận 17/09 (claude_2026-09-17_multi-leaf-throughput-diagnosis-selfhealing-plan.md). Số liệu 14/09: node_count 1, node_ids [1207449329], frames_ok 1306. Giới hạn: danh sách node phẳng, chưa có quan hệ cha/con nên chưa hiển thị số hop.

## Slide 9

Kiểm chứng ngược: rút nguồn một Leaf

Rút nguồn
Leaf

node_count
giảm

Cấp nguồn
lại

node_count
tăng

Ghi last_self_heal_ms

Notes: Quy trình 6 bước: rút nguồn 1 Leaf, theo dõi node_count giảm rồi tăng, đọc last_self_heal_ms, lặp 3–5 lần (claude_2026-09-17_multi-leaf-throughput-diagnosis-selfhealing-plan.md). 3 mẫu thô 885/10461/32528 ms — phân tán lớn, chưa dùng làm kết quả chính thức, cần ≥5 mẫu (2026-09-16_leaf-bringup-rf-diagnosis-power-plan.md; claude_2026-09-18...). Mới đo được kiểu tái kết nối, chưa đo đổi tuyến qua node trung gian.

## Slide 10

Kết quả đo: tỉ lệ mất khung ảnh

Nguyên nhân

Leaf A

Leaf B

Root: 1 slot

A và B đẩy khung của nhau ra

Đã sửa: 4 slot × 24 KB

Chưa nạp board, chưa đo lại

Notes: 1 Leaf: 1306 OK / 6 drop ~0,5% (2026-09-14_leaf-bringup-mesh-fix.md). 2 Leaf: 111 OK / 496 drop ~82% (claude_2026-09-17_multi-leaf...). UART sạch: 5 sai CRC / 16069 khung (~0,03%). Nguyên nhân: Root chỉ 1 slot ghép → eviction chéo; giả thuyết FrameAssembler ở middleware đã được đính chính là sai (claude_2026-09-18...). Sửa lên 4 slot trong code 26/09, chưa đo lại (nhat-ky_2026-09-26_den_2026-09-27.md).

## Slide 11

Tiến độ đã thực hiện

01/09

Chọn hướng
ESP-Mesh

12/09

Root
chạy thật

14/09

Leaf 1
ổn định

17/09

2 Leaf
đồng thời

27/09

Firmware
nhiều Leaf

10/09

Middleware
+ giao thức UART

13/09

Root → PC
thông suốt

16/09

Nạp
Leaf 2, 3

18/09

Tìm ra
lỗi drop

Notes: Mốc: 01/09 quyết định ESP-WIFI-MESH, giữ painlessMesh dự phòng (claude_migration-esp-wifi-mesh.md); 10/09 middleware + UART_PROTOCOL (claude_trang-thai-hien-tai.md); 12/09 bring-up Root (2026-09-12...); 13/09 khép kín Root→middleware (2026-09-13...); 14/09 Leaf 1 ổn định (2026-09-14...); 16/09 Leaf 2,3 + tranh chấp RF (2026-09-16...); 17/09 2 Leaf đồng thời (claude_2026-09-17...); 18/09 tìm nguyên nhân drop (claude_2026-09-18...); 26–27/09 firmware nhiều Leaf + dashboard mới, commit 5bc8f30 (nhat-ky_2026-09-26...). Tỉ lệ % hoàn thành cụ thể: không tìm thấy trong tài liệu hiện có.

## Slide 12

Trạng thái và bước tiếp theo

Throughput

Có số liệu 1–2 Leaf

Chưa đo theo hop

Tiếp theo

Latency

Chưa đo được

Header chưa có mốc thời gian

Self-healing

3 mẫu thô

Cần ≥ 5 mẫu

Nạp firmware
mới, đo lại

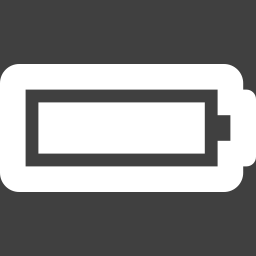
[picture p10: figure]

Hàn nguồn
pin 18650


Đo 1 / 2 / 3
hop

Đo self-healing
≥ 5 lần

Notes: Throughput: có drop rate 1–2 Leaf, chưa theo hop. Latency: bản painlessMesh không đo được vì header 12B không mang mốc thời gian chụp; chỉ bản ESP-IDF có capture_ts_ms. Self-healing: 3 mẫu phân tán (claude_2026-09-18_bao-cao-tien-do-va-kiem-tra-source-code.md). Việc tiếp theo theo thứ tự ưu tiên: nạp firmware 26/09 kiểm tra heap_free, Root ID, ChunksFail; hàn 3 bộ nguồn pin (việc chặn đường lớn nhất); bố trí Root→Relay→Leaf xa đo 1/2/3 hop; đo self-healing ≥5 lần; hỏi giảng viên về ESP-IDF vs painlessMesh (claude_2026-09-18...; nhat-ky_2026-09-26...).

## Slide 13

Cảm ơn thầy/cô
đã lắng nghe

Hỏi & đáp
