JoteraJ/do-an-chuyen-nganh-meshdrone/baocao/tiến độ/Tong_hop_bao_cao_50_WiFi_Mesh.docx

BÁO CÁO TIẾN ĐỘ 50%

Đồ án chuyên ngành mạng — Đề tài 14

Mạng WiFi Mesh kết nối Drone/Robot truyền ảnh ESP32-CAM

Sinh viên: Nguyễn Dương Hiếu — Tài liệu tổng hợp chuẩn bị báo cáo, cập nhật 27/09/2026

Cách đọc tài liệu này

Mọi thông tin quan trọng đều ghi rõ file nguồn trong dấu ngoặc (ví dụ (theo nhat-ky_2026-09-26_den_2026-09-27.md)). Khi hai file mâu thuẫn, tài liệu dùng file có ngày mới hơn và ghi chú ở Mục 7. Chỗ nào tài liệu dự án không có thông tin thì ghi rõ "không tìm thấy trong tài liệu hiện có".

Phần trả lời câu hỏi "Làm sao biết node đang hoạt động trong mạng mesh?" nằm ở Mục 3, có kèm câu trả lời mẫu để nói trước hội đồng và kịch bản demo.

# 1. Đồ án đang làm gì

Đồ án xây dựng một mạng WiFi mesh tự tổ chức giữa các module ESP32-CAM gắn trên drone/robot. Mỗi node di động chụp ảnh JPEG, cắt ảnh thành các gói nhỏ và gửi qua mesh về một node gốc (Root). Root ghép lại ảnh hoàn chỉnh, đẩy ảnh và số liệu trạng thái qua cổng UART lên máy tính, nơi một middleware Node.js chuyển tiếp dữ liệu tới dashboard web để hiển thị trực tiếp (theo claude_trang-thai-hien-tai.md).

Ba tiêu chí hội đồng dùng để đánh giá là throughput, latency và self-healing; cả ba đều được đo trên mesh nội bộ giữa các ESP32, không phụ thuộc việc Root có nối WiFi router hay không (theo 2026-09-13_middleware-test-wifi-debug.md). Đề bài yêu cầu cấu hình giao thức "ESP-Mesh hoặc BATMAN-adv"; BATMAN-adv bị loại vì là module kernel Linux, không chạy được trên ESP32 (FreeRTOS) (theo claude_migration-esp-wifi-mesh.md).

Quyết định kiến trúc quan trọng: không có node "Parent/Robot" riêng về phần cứng. Vai trò Leaf/Parent được tự bầu động theo RSSI lúc chạy, nên với 3 node di động + 1 Root vẫn dựng được chuỗi tối đa 3 hop (theo claude_trang-thai-hien-tai.md).

## 1.1 Phần cứng và phần mềm đang dùng thực tế

Thành phần | Thông số / trạng thái | Nguồn
Root Node | ESP32-32D DevKitC TypeC, lõi WROOM-32, chip USB-Serial CP2102 (COM7), không có PSRAM, UART 921600 baud | 2026-09-12_root-node-bringup.md
Leaf Node ×3 | ESP32-CAM camera OV3660, anten PCB, đế nạp USB tích hợp chip CH340, PSRAM ~4MB; Serial Monitor 115200 baud. Mua Shopee SAMIORE (thay đơn Tuyết Nga đã hủy) | 2026-09-14_leaf-bringup-mesh-fix.md
Thư viện mesh | Fork Alteriom/painlessMesh 2.0.3 (bản gốc dính bug scan GitLab #275) | 2026-09-14… ; 2026-09-16…
Core Arduino | esp32 by Espressif 2.0.17 (hạ từ 3.3.11) | 2026-09-13_middleware-test-wifi-debug.md
Tên mạng mesh | SSID ESP32_MESH_VIDEO, mật khẩu phải giống nhau ở mọi node | 2026-09-13_middleware-test-wifi-debug.md
Nguồn di động | Pin 18650 + đế pin + boost 5V (ngõ ra USB-A) + tụ 470uF; quy trình hàn 8 bước đã soạn, chưa hàn | 2026-09-16_leaf-bringup-rf-diagnosis-power-plan.md
PC | Middleware Node.js (Express + Socket.IO), dashboard React tại http://localhost:3000 | 2026-09-13… ; nhat-ky_2026-09-26…

# 2. Nguyên lý hoạt động

## 2.1 Kiến trúc 3 lớp

Lớp | Chức năng | Thành phần
Lớp 1 — Mesh | Các Leaf chụp ảnh, chia gói, gửi đa chặng về Root qua WiFi mesh | ESP32-CAM ×3 + Root, painlessMesh
Lớp 2 — UART | Root gửi ảnh đã ghép + telemetry + log lên PC theo khung nhị phân có CRC16 | Root → cáp USB (CP2102) → PC, 921600 baud
Lớp 3 — Ứng dụng | Middleware tách khung, phát sự kiện Socket.IO; dashboard hiển thị ảnh, số node, số liệu đo | Node.js + dashboard HTML/React

Kiến trúc này mô tả trong (theo claude_trang-thai-hien-tai.md) và hình 1 của bộ báo cáo 18/09 (theo claude_2026-09-18_bao-cao-tien-do-va-kiem-tra-source-code.md).

## 2.2 Mạng mesh hình thành như thế nào

Nền tảng là khả năng AP-STA đồng thời của chip ESP32: một node vừa là station kết nối lên node cha, vừa là access point nhận kết nối từ node con. Nhờ đó mạng hình thành topology dạng cây nhiều lớp (Root/Parent/Leaf) và truyền được đa chặng mà không cần router (theo tài_liệu, Phần 3.1). Khi khởi động, Leaf quét tìm mạng có SSID mesh; log thực tế ghi nhận Leaf tìm thấy Root (Found 1 nodes, ESP32_MESH_VIDEO, -57dBm) rồi gọi connectToAP() (theo 2026-09-14_leaf-bringup-mesh-fix.md).

Khi một node cha trung gian hỏng, các node con thử kết nối lại, sau đó tự chọn node cha mới trong tầm phủ sóng; mạng có thể phải thêm một lớp, khiến số hop và độ trễ tăng. Đây là cơ chế self-healing (theo tài_liệu, Phần 3.2). Firmware Root đo thời gian phục hồi qua hai callback onDroppedConnection và onChangedConnections, báo về bằng trường last_self_heal_ms (theo claude_trang-thai-hien-tai.md).

## 2.3 Luồng truyền một khung ảnh (firmware bản 27/09)

1. Chụp ảnh tại Leaf. Camera OV3660 chụp JPEG. Nếu chưa biết Root và mesh không có node nào thì bỏ qua, không chụp; khung lớn hơn 24KB bị Leaf tự loại trước khi gửi (theo nhat-ky_2026-09-26_den_2026-09-27.md).
2. Chia gói. Ảnh được cắt thành các chunk 1024 byte, mỗi chunk có header 12 byte mang thông tin phân biệt node gửi và khung (theo claude_trang-thai-hien-tai.md) (theo claude_2026-09-18_bao-cao-tien-do-va-kiem-tra-source-code.md); bản triển khai thật đã xác nhận có trường node ID (theo claude_2026-09-17_multi-leaf-throughput-diagnosis-selfhealing-plan.md).
3. Mã hóa Base64. painlessMesh chỉ nhận String nên dữ liệu nhị phân phải mã hóa Base64 (tăng ~33% dữ liệu) (theo claude_migration-esp-wifi-mesh.md).
4. Gửi thẳng về Root. Root phát beacon #ROOT mỗi 2000 ms; Leaf nghe beacon để học root_id, sau đó gửi bằng mesh.sendSingle(root_id, ...). Chưa biết Root thì tạm dùng sendBroadcast(). Nếu Root biến khỏi danh sách node, Leaf reset root_id và học lại (theo nhat-ky_2026-09-26_den_2026-09-27.md).
5. Ghép ảnh tại Root. Root có 4 slot ghép song song (4 × 24KB = 96KB SRAM), dùng bitmap đánh dấu chunk đã nhận, timeout 2000 ms, và cơ chế "supersede": khi khung mới của cùng node tới thì hủy khung cũ đang ghép dở (theo nhat-ky_2026-09-26_den_2026-09-27.md).
6. Gửi lên PC. Root đóng khung UART gồm MAGIC + TYPE + LEN + CRC16; TYPE = 0x01 là ảnh đã ghép xong, ngoài ra có khung telemetry JSON gửi mỗi 2 giây (theo claude_trang-thai-hien-tai.md) (theo 2026-09-12_root-node-bringup.md) (theo claude_2026-09-18_bao-cao-tien-do-va-kiem-tra-source-code.md).
7. Middleware và dashboard. Middleware tách khung, kiểm CRC, phát 5 sự kiện Socket.IO (connect, disconnect, status, telemetry, frame). Dashboard có tab Live và tab So sánh 1/2/3 leaf, không dùng dữ liệu giả lập (theo nhat-ky_2026-09-26_den_2026-09-27.md).

Mẫu telemetry thật do Root gửi (đo ngày 12/09, khi chưa có Leaf) (theo 2026-09-12_root-node-bringup.md):

{"ts":16000,"role":"root","layer":0,"frames_ok":0,"frames_drop":0,"chunks":0,"heap_free":122636,"psram_free":0,"node_count":0,"node_ids":[],"last_self_heal_ms":-1}

# 3. Làm sao biết node đang hoạt động trong mạng mesh?

Câu trả lời ngắn (nói trước hội đồng)

Em không dựa vào một dấu hiệu duy nhất mà kiểm chứng theo 4 tầng. Thứ nhất, tại chính node: Serial log cho thấy node quét thấy mạng ESP32_MESH_VIDEO, kết nối được và học được ID của Root. Thứ hai, tại Root: mỗi 2 giây Root báo node_count và danh sách node_ids lấy từ bảng node của mesh — ID của Leaf phải xuất hiện trong đó. Thứ ba, tại PC: API /status và dashboard cho biết khung ảnh mới nhất đến từ node ID nào. Thứ tư, và là bằng chứng mạnh nhất: ảnh của Leaf đến được dashboard trong khi Leaf chỉ được cấp nguồn, không có dây dữ liệu nào nối với PC — dữ liệu chỉ có thể đi qua sóng mesh. Cuối cùng, em kiểm chứng ngược bằng cách rút nguồn một Leaf: node_count giảm, cấp nguồn lại thì tăng trở lại và Root ghi thời gian phục hồi.

Cơ sở: (theo 2026-09-14_leaf-bringup-mesh-fix.md) (theo claude_2026-09-17_multi-leaf-throughput-diagnosis-selfhealing-plan.md) (theo nhat-ky_2026-09-26_den_2026-09-27.md).

## 3.1 Bảng kiểm tra theo 4 tầng

Tầng | Xem ở đâu | Dấu hiệu ĐANG trong mesh | Dấu hiệu KHÔNG trong mesh
1. Tại Leaf | Serial Monitor của Leaf (115200 baud) | [MESH] Node ID: ... sau RST; Found 1 nodes, ESP32_MESH_VIDEO, -57dBm rồi connectToAP(); [MESH] Root ID = ... trong vài giây đầu; dòng [STAT] có ChunksFail gần 0 | Mọi chunk báo THAT BAI; lặp connected but unrooted → Found 0 nodes; lỗi stationScan(): scan could not start
2. Tại Root | Telemetry JSON mỗi 2 s | node_count ≥ 1; node_ids chứa đúng ID của Leaf; frames_ok và chunks tăng liên tục | node_count = 0 hoặc dao động 1–2; frames_ok đứng yên
3. Tại PC | http://localhost:3000/status | serialConnected: true; latestFrameMeta.nodeId = ID của Leaf; framesBadCrc ≈ 0 | serialConnected: false (lỗi đường Root–PC, không phải lỗi mesh)
4. Dashboard | Header và tab Live | Badge số LEAF đúng; ảnh từng node báo "vừa xong" | Ảnh đứng yên kèm "X giây trước" tăng dần

Nguồn cho bảng: tầng 1 (theo 2026-09-14_leaf-bringup-mesh-fix.md) (theo 2026-09-16_leaf-bringup-rf-diagnosis-power-plan.md) (theo nhat-ky_2026-09-26_den_2026-09-27.md); tầng 2–3 (theo 2026-09-12_root-node-bringup.md) (theo 2026-09-13_middleware-test-wifi-debug.md) (theo claude_2026-09-17_multi-leaf-throughput-diagnosis-selfhealing-plan.md); tầng 4 (theo nhat-ky_2026-09-26_den_2026-09-27.md).

## 3.2 Số liệu thật đã chứng minh node nằm trong mesh

Ngày 14/09, với 1 Leaf, /status báo node_count: 1, node_ids: [1207449329], frames_ok: 1306, frames_drop: 6 và middleware ghi log ghép ảnh "HOAN THANH" liên tục đúng frame_id, xác nhận dữ liệu ảnh tới nơi nguyên vẹn chứ không chỉ "gửi thành công" ở tầng mesh (theo 2026-09-14_leaf-bringup-mesh-fix.md). Ngày 17/09, với 2 Leaf, node_count: 2 giữ ổn định với hai ID 1207433521 và 1207449329, cả hai cùng gửi ảnh liên tục; buổi đó cũng xác nhận Leaf tham gia mesh hoàn toàn qua sóng WiFi, cáp USB chỉ để cấp nguồn (theo claude_2026-09-17_multi-leaf-throughput-diagnosis-selfhealing-plan.md).

Để đối chiếu đúng node nào là node nào, đọc dòng [MESH] Node ID trên Serial của từng board ngay sau khi nhấn RST. Cách này từng dùng để loại bỏ giả thuyết trùng Node ID: Leaf2 = 1207433521, Leaf3 = 1207369673, Root = 2846999225 (theo 2026-09-16_leaf-bringup-rf-diagnosis-power-plan.md).

## 3.3 Kiểm chứng chủ động bằng self-healing

Quy trình 6 bước đã thiết kế: đánh dấu mốc t0 khi rút nguồn một Leaf, theo dõi node_count giảm rồi tăng lại, đọc last_self_heal_ms trong telemetry, lặp lại 3–5 lần để lấy min/max/trung bình (theo claude_2026-09-17_multi-leaf-throughput-diagnosis-selfhealing-plan.md). Ba mẫu thô đã ghi được là 885 ms, 10461 ms và 32528 ms, còn phân tán quá lớn nên chưa dùng làm kết quả chính thức (theo 2026-09-16_leaf-bringup-rf-diagnosis-power-plan.md) (theo claude_2026-09-18_bao-cao-tien-do-va-kiem-tra-source-code.md).

## 3.4 Giới hạn cần nói thẳng nếu hội đồng hỏi sâu

Thứ nhất, Root hiện chỉ báo danh sách node phẳng lấy từ mesh.getNodeList(), chưa có quan hệ cha/con hay RSSI của từng liên kết. Vì vậy hệ thống chứng minh được node có mặt trong mesh, nhưng dashboard chưa chỉ ra được node đó đi qua mấy hop; hai Leaf trong lần test 17/09 được suy luận là nối trực tiếp 1 hop vào Root dựa trên khoảng cách vật lý (theo claude_trang-thai-hien-tai.md) (theo claude_2026-09-17_multi-leaf-throughput-diagnosis-selfhealing-plan.md). Thứ hai, node_count là tổng số node trong mesh trừ Root, hiện đúng bằng số Leaf vì mọi node đều có camera (theo nhat-ky_2026-09-26_den_2026-09-27.md). Thứ ba, khi node rớt, dashboard vẫn giữ ảnh cuối cùng kèm đồng hồ "X giây trước", dễ gây hiểu nhầm là còn dữ liệu — phải nhìn thời gian cập nhật chứ không chỉ nhìn ảnh (theo claude_2026-09-17_multi-leaf-throughput-diagnosis-selfhealing-plan.md).

## 3.5 Kịch bản demo đề xuất tại buổi báo cáo

1. Cắm Root vào PC, đóng Serial Monitor trước rồi mới chạy node server.js COM7, vì chỉ một chương trình được giữ COM7 tại một thời điểm (theo 2026-09-13_middleware-test-wifi-debug.md).
2. Mở dashboard: lúc chưa có Leaf, badge LEAF = 0 và node_ids rỗng.
3. Cấp nguồn cho một Leaf (chỉ nguồn, không dây dữ liệu). Chờ vài giây: node_count lên 1, ID xuất hiện trong node_ids, ảnh bắt đầu chạy.
4. Mở /status để hội đồng thấy latestFrameMeta.nodeId trùng ID của Leaf.
5. Rút nguồn Leaf: node_count giảm, ảnh chuyển sang "X giây trước". Cấp nguồn lại: node quay lại và last_self_heal_ms được cập nhật.

Lưu ý: firmware bản 27/09 chưa có bằng chứng đã nạp và chạy thử trên board (theo nhat-ky_2026-09-26_den_2026-09-27.md). Nếu demo bằng bản này, nên nạp và kiểm tra trước buổi báo cáo; nếu không kịp, demo bằng bản đã chạy ổn định 1 Leaf (14/09).

# 4. Tiến độ hiện tại

## 4.1 Các mốc đã hoàn thành

Ngày | Việc đã làm | Nguồn
01/09 | Quyết định hướng ESP-WIFI-MESH (ESP-IDF), giữ painlessMesh làm phương án dự phòng; scaffold Phase 1 | claude_migration-esp-wifi-mesh.md
10/09 | Viết UART_PROTOCOL (MAGIC+TYPE+LEN+CRC16), middleware Node.js mới hoàn toàn, test parser 7/7; thêm đo self-healing vào Root | claude_trang-thai-hien-tai.md
12/09 | Bring-up board Root: cài driver CP2102, sửa firmware vì board không có PSRAM; telemetry gửi đều mỗi 2 s | 2026-09-12_root-node-bringup.md
13/09 | Khép kín chuỗi Root → UART → middleware; hạ log painlessMesh, bytesSkipped giảm từ 1.308.534 xuống 1.098 byte | 2026-09-13_middleware-test-wifi-debug.md
14/09 | Leaf #1 chạy ổn định 1 hop sau khi đổi sang fork Alteriom và tắt STA-bridge của Root | 2026-09-14_leaf-bringup-mesh-fix.md
16/09 | Nạp firmware Leaf #2, #3; xác định tranh chấp RF khi đặt Leaf quá gần; 3 mẫu self-healing đầu tiên; soạn quy trình hàn nguồn | 2026-09-16_leaf-bringup-rf-diagnosis-power-plan.md
17/09 | Sửa lỗi dashboard Cannot GET /; chạy được 2 Leaf đồng thời, đo drop rate | claude_2026-09-17_…(2 file)
18/09 | Đọc lại toàn bộ source, tìm ra nguyên nhân drop ~82% (Root chỉ có 1 slot ghép); lập báo cáo tiến độ .docx 21 trang + 7 hình | claude_2026-09-18_bao-cao-tien-do-va-kiem-tra-source-code.md
26–27/09 | Sửa firmware cho nhiều Leaf (4 slot, supersede, beacon Root, sendSingle), viết lại dashboard (345 → 1274 dòng), push commit 5bc8f30 | nhat-ky_2026-09-26_den_2026-09-27.md

## 4.2 Số liệu đã đo được

Phép đo | Kết quả | Nguồn
1 Leaf, 1 hop | frames_ok 1306 / frames_drop 6 → ~0,5% drop | 2026-09-14_leaf-bringup-mesh-fix.md
2 Leaf đồng thời (firmware cũ, 1 slot) | 111 OK / 496 drop → ~82% drop | claude_2026-09-17_multi-leaf…
Đường UART Root–PC | 5 khung sai CRC / 16069 khung OK (~0,03%) | claude_2026-09-17_multi-leaf…
Self-healing (mẫu thô) | 885 ms; 10461 ms; 32528 ms | 2026-09-16_leaf-bringup-rf-diagnosis-power-plan.md
Heap trống tại Root | 122636 byte (~120KB), đo 12/09 | 2026-09-12_root-node-bringup.md

Nguyên nhân drop ~82% khi chạy 2 Leaf: Root chỉ có 1 slot ghép ảnh, nên chunk của Leaf này liên tục đẩy khung đang ghép dở của Leaf kia ra ngoài (eviction chéo). Giả thuyết ngày 17/09 cho rằng lỗi nằm ở "FrameAssembler" của middleware đã được đính chính là sai — middleware không ghép ảnh (theo claude_2026-09-18_bao-cao-tien-do-va-kiem-tra-source-code.md). Bản sửa (4 slot) đã có trong code 26/09 nhưng chưa đo lại (theo nhat-ky_2026-09-26_den_2026-09-27.md).

## 4.3 Trạng thái 3 tiêu chí chấm

Tiêu chí | Trạng thái | Nguồn
Throughput | Có số liệu 1 Leaf và 2 Leaf (drop rate). Chưa đo theo 1/2/3 hop. Dashboard đã có tab so sánh 1/2/3 leaf (FPS, KB/s, drop %, ...) | claude_2026-09-18…; nhat-ky_2026-09-26…
Latency | Chưa đo được trên bản painlessMesh vì header chunk 12 byte không mang mốc thời gian chụp; chỉ bản ESP-IDF có capture_ts_ms | claude_2026-09-18_bao-cao-tien-do-va-kiem-tra-source-code.md
Self-healing | Có 3 mẫu thô, phân tán lớn; mới đo được kiểu "tái kết nối", chưa đo kiểu "đổi tuyến qua node trung gian" vì cần bố trí chuỗi 3 node | claude_2026-09-17_multi-leaf…; claude_2026-09-18…

Về con số "50%": không tìm thấy trong tài liệu hiện có một tỷ lệ phần trăm hoàn thành được tính cụ thể. Các file chỉ liệt kê việc đã xong và việc còn lại như trên.

# 5. Việc còn lại (theo thứ tự ưu tiên)

1. Nạp firmware 26/09, kiểm tra ngay heap_free của Root (buffer tăng từ 64KB lên 96KB SRAM), Leaf in được [MESH] Root ID, ChunksFail gần 0, rồi đo lại drop rate 2–3 Leaf (theo nhat-ky_2026-09-26_den_2026-09-27.md). Nếu thiếu heap thì lùi về 3 slot (theo claude_2026-09-18_bao-cao-tien-do-va-kiem-tra-source-code.md).
2. Hàn 3 bộ nguồn pin 18650 — đây là việc chặn đường lớn nhất, vì còn cắm cáp USB thì không tách node ra xa được (theo claude_2026-09-18_bao-cao-tien-do-va-kiem-tra-source-code.md).
3. Bố trí chuỗi Root → Relay → Leaf xa, đo throughput 1/2/3 hop và self-healing "đổi tuyến" (theo claude_2026-09-17_multi-leaf-throughput-diagnosis-selfhealing-plan.md).
4. Đo self-healing lặp lại ít nhất 5 lần, ghi min/max/trung bình (theo claude_2026-09-18_bao-cao-tien-do-va-kiem-tra-source-code.md).
5. Giải quyết latency: mở rộng header bản painlessMesh hoặc chuyển sang ESP-IDF; hỏi giảng viên xem "ESP-Mesh" có bắt buộc đúng API Espressif không (theo claude_2026-09-18_bao-cao-tien-do-va-kiem-tra-source-code.md) (theo claude_migration-esp-wifi-mesh.md).
6. Bổ sung quan hệ cha/con vào telemetry để dashboard vẽ được cây topology thật (theo claude_2026-09-18_bao-cao-tien-do-va-kiem-tra-source-code.md).
7. Hạng mục đo vùng phủ sóng (RSSI theo khoảng cách) đề bài yêu cầu nhưng chưa có trong kế hoạch (theo claude_migration-esp-wifi-mesh.md).
8. Việc phụ về repo: commit .gitignore đã sửa và gỡ node_modules (1206 file) khỏi git (theo nhat-ky_2026-09-26_den_2026-09-27.md).

# 6. Câu hỏi hội đồng có thể hỏi

Hỏi: Tại sao dùng painlessMesh mà không phải ESP-WIFI-MESH đúng đề bài?

Đáp: Bản painlessMesh là bản "chắc ăn" đã chạy trên board thật. Bản ESP-IDF dùng đúng API esp_mesh đã biên dịch thành công nhưng chưa nạp lên board, ảnh còn giả lập bằng fill_fake_jpeg() (theo claude_2026-09-18_bao-cao-tien-do-va-kiem-tra-source-code.md). Việc chọn bản nộp chính thức đang chờ hỏi giảng viên (theo claude_migration-esp-wifi-mesh.md).

Hỏi: Tại sao không dùng BATMAN-adv?

Đáp: BATMAN-adv là module kernel Linux, ESP32 chạy FreeRTOS không có kernel Linux; muốn dùng phải đổi sang Raspberry Pi/router Linux, phá vỡ BOM đã chốt (theo claude_migration-esp-wifi-mesh.md).

Hỏi: Mạng này có phải mạng Bus không? Node giữa chết thì sao?

Đáp: Không phải Bus. Nếu nối tiếp thành chuỗi thì là dạng Linear/Daisy-chain, một dạng suy biến của mesh. Node giữa chết thì các node ngoài không chết theo về vật lý; nếu node đó là "cây cầu" duy nhất thì phía ngoài bị cô lập, còn nếu mật độ node đủ dày thì chúng tìm đường vòng — đó là self-healing (theo Tong_Hop_Mang_Mesh_Drone.md).

Hỏi: Tại sao cắt ảnh thành chunk 1024 byte mà không giảm nhỏ hơn?

Đáp: Nghiên cứu ngày 17/09 cho thấy trong mạng 802.11 bão hòa, giảm kích thước gói làm tăng số frame, dễ phản tác dụng với đúng loại nghẽn đang gặp; khuyến nghị giữ 1024 (theo claude_2026-09-17_multi-leaf-throughput-diagnosis-selfhealing-plan.md) (theo compass_artifact_wf-af62a29b-e9ce-57b8-b0d3-d95e01e257fd_text_markdown.md).

Hỏi: Tại sao đổi từ broadcast sang gửi thẳng Root?

Đáp: sendBroadcast() gửi gói tới toàn bộ node, kể cả các Leaf không cần, làm tăng lượng gói trên không khí và sai lệch số liệu throughput theo hop (theo claude_2026-09-18_bao-cao-tien-do-va-kiem-tra-source-code.md) (theo claude_migration-esp-wifi-mesh.md).

Hỏi: Nếu sửa slot rồi mà drop vẫn cao thì làm gì?

Đáp: Thử staggering (các Leaf lệch pha thời điểm gửi bằng mesh.getNodeTime()), sau đó cân nhắc chuyển luồng ảnh sang ESP-NOW, giữ painlessMesh cho telemetry (theo claude_2026-09-17_multi-leaf-throughput-diagnosis-selfhealing-plan.md).

# 7. Ghi chú về nguồn và các điểm mâu thuẫn

Nội dung | File cũ nói | Đang dùng (file mới hơn)
Bản ESP-IDF đã biên dịch chưa | Chưa compile-test lần nào (claude_trang-thai-hien-tai.md, 10/09; claude_migration-esp-wifi-mesh.md) | Đã biên dịch thành công, có file .bin, chưa nạp board (claude_2026-09-18…, 18/09)
Nơi mua ESP32-CAM | Điện Tử Tuyết Nga, 525.000đ (claude_trang-thai-hien-tai.md) | Shopee SAMIORE, đơn Tuyết Nga đã hủy (2026-09-14…, 14/09)
Số slot ghép ảnh của Root | 1 slot, 64KB (claude_2026-09-18…) | 4 slot × 24KB (nhat-ky_2026-09-26…, 27/09) — trong code, chưa nạp
Mức log painlessMesh | ERROR | CONNECTION còn bật (14/09, 16/09, 18/09) | Đã hạ về ERROR ở cả Root và Leaf (nhat-ky_2026-09-26…)
Nguyên nhân drop 82% | FrameAssembler một buffer ở middleware (claude_2026-09-17_multi-leaf…) | Root chỉ có 1 slot; middleware không ghép ảnh (claude_2026-09-18…)
Mạch nạp cho Leaf | Dùng FT232RL rời (claude_trang-thai-hien-tai.md) | Board có sẵn đế nạp USB chip CH340 (2026-09-14…)

Hai file tổng hợp trạng thái claude_trang-thai-hien-tai.md (dừng ở 10/09) và claude_migration-esp-wifi-mesh.md đã lỗi thời so với các nhật ký sau đó (theo claude_2026-09-18_bao-cao-tien-do-va-kiem-tra-source-code.md). Các thông tin không tìm thấy trong tài liệu hiện có: số liệu latency, throughput theo số hop, số liệu vùng phủ sóng theo khoảng cách, kết quả chạy thật của firmware 26/09, và tỷ lệ % hoàn thành chính thức.

Đề tài 14 — Báo cáo tiến độ 50% — trang
