JoteraJ/do-an-chuyen-nganh-meshdrone/baocao/tiến độ/BAO_CAO_NGAN_18-09-2026.pptx

BÁO CÁO TIẾN ĐỘ · ĐỀ TÀI 14

Mạng WiFi Mesh
kết nối Drone và Robot

Hệ thống đã chạy thông suốt với 1 Drone. Đang xử lý nghẽn khi chạy nhiều Drone cùng lúc.

Nguyễn Dương Hiếu
18 / 09 / 2026

Notes: Em bao cao tien do trong 5 phut: he thong lam gi, da chay duoc den dau, dang vuong gi, va tuan toi lam gi.

## Slide 2

Hệ thống làm gì

Ảnh đi từ Drone về máy tính qua mạng mesh tự tổ chức, không cần router

Drone

ESP32-CAM chụp ảnh
rồi cắt nhỏ gửi đi

1

Mạng mesh

Các node tự nối nhau,
chuyền tiếp hộ nhau

2

Root

Ghép lại thành ảnh,
đẩy xuống máy tính

3

Dashboard

Hiện ảnh và các
thông số mạng

4

Vì sao cần mesh

Ở vùng thảm hoạ hay hầm mỏ không có router. Các node tự nối nhau và chuyền tiếp hộ, nên node ở xa vẫn gửi được dữ liệu về.

Thầy sẽ chấm ba chỉ số

Throughput theo số chặng · Độ trễ · Thời gian mạng tự phục hồi khi mất một node. Đây mới là phần đồ án phải chứng minh bằng số liệu.

Notes: Nhan manh: de tai khong phai lap trinh ESP32 chup anh, ma la do luong hanh vi cua mang vo tuyen da chang.

## Slide 3

Đã làm được đến đâu

Số đo thật trên board, không phải mô phỏng

3 + 1

board đã chạy

3 Drone ESP32-CAM
+ 1 Root nối máy tính

Ba phần đã hoàn chỉnh

1306 / 6

ảnh nhận / mất

Chạy 1 Drone
mất 0,5 % — rất tốt

2–3

khung hình / giây

Ảnh hiện liên tục
trên dashboard

Drone chụp ảnh, cắt nhỏ, gửi qua mesh. Root ghép lại thành ảnh hoàn chỉnh.

Đóng gói có mã kiểm lỗi — đo được 16 069 gói đúng, chỉ 5 gói sai (0,03 %).

Đọc dữ liệu từ board, hiện ảnh và thông số mạng lên trình duyệt.

Firmware

Đường truyền về PC

Phần mềm trên PC

Notes: Diem manh: da di tron ven tu cam bien anh, qua mesh, qua UART, qua phan mem, den trinh duyet — bang du lieu that.

## Slide 4

Đang vướng gì

Chạy 2 Drone cùng lúc thì mất 82 % ảnh

Nguyên nhân — đã tìm ra

Root chỉ có một chỗ chứa ảnh đang ghép dở. Ảnh của Drone A chưa ghép xong thì mảnh của Drone B tới, Root phải bỏ ảnh của A đi để nhận của B — rồi lặp lại liên tục.

Cách sửa — sửa được ngay

Cho Root 4 chỗ chứa thay vì 1, đồng thời giảm dung lượng mỗi chỗ cho vừa bộ nhớ. Chỉ sửa hai dòng cấu hình, nạp lại rồi đo lại ngay.

Việc chặn đường lớn hơn: chưa hàn nguồn pin

Cả 4 board vẫn cắm cáp USB vào máy tính nên bị buộc nằm cạnh nhau trên bàn. Không tách được các node ra xa thì không dựng được chuỗi 2–3 chặng, nên hai trong ba chỉ số thầy chấm — throughput theo số chặng và độ trễ — vẫn chưa có số liệu. Linh kiện đã mua đủ, chỉ còn hàn.

Notes: Neu thay hoi ve con so 82%: day khong phai ket qua cuoi cung ma la phat hien trong qua trinh do, nguyen nhan da truy den ma nguon va huong sua da ro.

## Slide 5

Kế hoạch tuần tới

Làm xong ba việc này là mở khoá được cả ba chỉ số chấm điểm

Sửa hai dòng, nạp lại firmware, chạy 2 Drone và đọc lại tỉ lệ mất ảnh. Mất khoảng một buổi.

1

Sửa cấu hình Root rồi đo lại

Để tách các Drone ra xa nhau. Linh kiện đã có đủ, quy trình hàn đã chuẩn bị sẵn.

Hàn ba bộ nguồn pin 18650

2

Đo throughput ở 1, 2, 3 chặng; đo thời gian mạng tự phục hồi, lặp ít nhất 5 lần lấy trung bình.

Báo cáo đầy đủ kèm 7 sơ đồ khối và lưu đồ giải thuật đã có sẵn, em xin gửi thầy bản Word.

3

Đo ba chỉ số và ghi số liệu

Notes: Ket thuc. Neu thay muon xem chi tiet thuat toan hay so lieu day du, em co ban bao cao Word 21 trang kem 7 hinh.
