JoteraJ/do-an-chuyen-nganh-meshdrone/baocao/DoAn_WiFiMesh_LaTeX/main.tex

% !TeX program = xelatex
% !TeX encoding = UTF-8
% ============================================================
%  ĐỒ ÁN CHUYÊN NGÀNH — KHOA ĐIỆN – ĐIỆN TỬ, ĐẠI HỌC TÔN ĐỨC THẮNG
%  Template LaTeX chuyển từ mẫu MauDATN_2021
%
%  BIÊN DỊCH: XeLaTeX  (Overleaf: Menu > Compiler > XeLaTeX)
%  Thông tin sinh viên, đề tài, GVHD: sửa trong thongtin.tex
%  Định dạng trang, font, tiêu đề:      sửa trong cauhinh.tex
% ============================================================
\documentclass[a4paper,oneside]{report}

\input{thongtin}
\input{cauhinh}

\begin{document}

% ---------------- PHẦN ĐẦU (đánh số i, ii, iii...) ----------------
% Thứ tự theo hướng dẫn trình bày của Trường: bìa chính, bìa phụ, lời cảm ơn,
% lời cam đoan, phiếu nhiệm vụ, lịch trình, tóm tắt, abstract, mục lục,
% danh mục hình, danh mục bảng, danh mục chữ viết tắt.
\pagenumbering{roman}
\pagestyle{phandau}

\input{frontmatter/biachinh}
\input{frontmatter/biaphu}
\input{frontmatter/loicamon}
\input{frontmatter/camdoan}
\input{frontmatter/nhiemvu}
\input{frontmatter/lichtrinh}
\input{frontmatter/tomtat}
\input{frontmatter/abstract}

\tableofcontents
\listoffigures
\listoftables
\input{frontmatter/viettat}

% ---------------- NỘI DUNG CHÍNH (đánh số 1, 2, 3...) ----------------
\batdaunoidung

\input{chapters/chuong1}
\input{chapters/chuong2}
\input{chapters/chuong3}
\input{chapters/chuong4}
\input{chapters/chuong5}

% ---------------- TÀI LIỆU THAM KHẢO ----------------
\bibliographystyle{apalike-vn}
\bibliography{references}

% ---------------- PHỤ LỤC ----------------
\batdauphuluc
\input{appendix/phuluca}

\end{document}
