JoteraJ/do-an-chuyen-nganh-meshdrone/baocao/DoAn_WiFiMesh_LaTeX/thongtin.tex

% ============================================================
%  THÔNG TIN ĐỒ ÁN — chỉ cần sửa ở đây, mọi trang bìa tự cập nhật
% ============================================================
\newcommand{\tensinhvien}{NGUYỄN DƯƠNG HIẾU}
\newcommand{\tensinhvienthuong}{Nguyễn Dương Hiếu}
\newcommand{\mssv}{42300151}
\newcommand{\lop}{23040202}

\newcommand{\tendetai}{THIẾT KẾ MẠNG WIFI MESH KẾT NỐI DRONE VÀ ROBOT}
% Tên đề tài tách 2 dòng cho bìa phụ
\newcommand{\tendetaidongmot}{THIẾT KẾ MẠNG WIFI MESH}
\newcommand{\tendetaidonghai}{KẾT NỐI DRONE VÀ ROBOT}
\newcommand{\tendetaithuong}{Thiết kế mạng WiFi Mesh kết nối Drone và Robot}
\newcommand{\tendetaitienganh}{DESIGN OF A WIFI MESH NETWORK FOR CONNECTING DRONES AND ROBOTS}

\newcommand{\loaidoan}{ĐỒ ÁN CHUYÊN NGÀNH}
\newcommand{\loaidoanthuong}{Đồ án chuyên ngành}
\newcommand{\nganh}{KỸ THUẬT ĐIỆN TỬ – VIỄN THÔNG}

% Học hàm, học vị, họ tên giảng viên hướng dẫn
\newcommand{\gvhd}{PGS.TS. Đặng Ngọc Minh Đức}

\newcommand{\namthuchien}{2026}
\newcommand{\ngayky}{TP. Hồ Chí Minh, ngày ..... tháng ..... năm \namthuchien}
