JoteraJ/do-an-chuyen-nganh-meshdrone/docs/nhatkylamviec/nhat-ky_2026-09-29_den_2026-09-30.md

# Nhật ký làm việc 29/09 → rạng sáng 30/09/2026 (bản cập nhật)

> Đồ án WiFi Mesh Drone/Robot (painlessMesh, ESP32-CAM).
>
> Bản này **thay thế** bản "Nhật ký làm việc 29/09 → rạng sáng 30/09/2026" trước đó. Bản mới bổ sung thêm ba phần: kết quả **test14.csv**, việc **sửa dashboard (đổi leaf → drone, đánh số drone)**, và sự cố **auto mode của Claude Code**.
>
> Quy ước giờ: giờ ghi trong file là **giờ Việt Nam** (UTC+7), trừ khi ghi rõ UTC. Dữ liệu đo lấy từ các file CSV xuất ở tab so sánh của dashboard.

---

## 1. Tóm tắt

Buổi làm việc bắt đầu từ lỗi phát hiện trong CSV ngày 28/09: khi chạy 3 Leaf bằng pin, **toàn bộ mạng đứng sau 6–26 giây**. Nguyên nhân được xác định là **Root quá tải**. Lỗi được khắc phục bằng cách tăng chu kỳ chụp của Leaf từ 300 ms lên 600 ms.

Sau đó hệ thống được bổ sung các chức năng sau:
- Đo **latency** (từ lúc chụp đến lúc ghép xong tại Root).
- Hiển thị **cây topology** kèm **RSSI** và **phiên bản firmware** của từng node.
- Xuất **latency, hop và RSSI theo từng node** ra CSV.

Kết quả chính có hai lần đo:
- **test13.csv** (01:08 → 01:14): 3 Leaf chạy liên tục **6 phút 14 giây**, tỉ lệ hủy frame **0%**, khoảng 5 fps tổng. Topology có 2 node ở hop 1 và 1 node ở hop 2.
- **test14.csv** (01:25 → 01:30): 3 Leaf chạy liên tục **5 phút 2 giây**, không rớt node. Lần này **cả 3 node cùng nối thẳng vào Root (hop 1)**. Đây là lần đầu có số liệu latency của **cùng một board ở hop 1 và hop 2**: hop 2 chậm hơn khoảng **175 ms**.

Dashboard được giao Claude Code sửa để hiển thị theo tên đề tài. Tab so sánh đổi tên thành "Bảng so sánh", chữ "leaf" đổi thành "drone", badge đổi thành "Tổng x Drone", và mỗi drone được đánh số theo thứ tự kết nối. **Chưa xác nhận xong** (xem mục 3.2).

Về kiến trúc, đã chốt **giữ painlessMesh làm bản chính thức**, dừng bản ESP-IDF và gác lại ESP-NOW (chi tiết trong `claude_2026-09-29_cap-nhat-trang-thai-quyet-dinh-painlessmesh.md`).

---

## 2. Điểm xuất phát: lỗi đứng mạng trong CSV 28/09

CSV ngày 28/09 đo với firmware 27/09 (4 slot ghép ảnh, `sendSingle` qua beacon `#ROOT`) và chu kỳ chụp 300 ms, mỗi Leaf khoảng 3.3 fps.

Khi mạng còn chạy, FPS tổng tăng tuyến tính 3.5 → 7 → 10 theo 1/2/3 Leaf, drop 0–5%, so với 82% hôm 17/09. Nhưng với 3 Leaf, mạng đứng hẳn sau vài giây. FPS tổng về 0 trong hơn 38 giây trong khi Root vẫn báo đủ 3 node. Heap Root tụt từ khoảng 90KB xuống 57KB và tiếp tục giảm. Các Leaf dừng cùng lúc, nên nguyên nhân nằm ở điểm chung của chúng là Root.

Giả thuyết: ở mức 3 Leaf × 3.3 fps, Root phải đẩy khoảng 47KB/s ảnh qua UART 921600 baud, trong khi mức tối đa là khoảng 92KB/s. Như vậy `loop()` dành gần nửa thời gian để ghi UART, `mesh.update()` bị gọi thưa, và dữ liệu dồn lại trong các kết nối TCP của painlessMesh.

---

## 3. Thay đổi code trong ngày

### 3.1 Firmware và dashboard (đã nạp, đã xác nhận qua dữ liệu đo)

Các thay đổi đều làm bằng Claude Code theo prompt, **chưa commit**.

| # | Phạm vi | Thay đổi | Board phải nạp |
|---|---|---|---|
| 1 | Leaf (`node_camera/mesh_config.h`) | `CAPTURE_INTERVAL_MS` 300 → 600 (~3.3 → ~1.7 fps mỗi Leaf) | 3 Leaf |
| 2 | Leaf + Root + dashboard | **Latency**: thêm `capture_us` (lấy từ `mesh.getNodeTime()`) vào `ChunkHeader`, header 12 → 16 byte. Root tính `latency = getNodeTime() − capture_us` khi ghép xong (phép trừ không dấu), bỏ mẫu > 10 s. Telemetry có thêm `lat_avg_ms`, `lat_min_ms`, `lat_max_ms`, `lat_n`, `lat_by_node` | Root + 3 Leaf |
| 3 | Leaf + Root + dashboard | **Topology, RSSI, firmware**: Leaf gửi `#NSTAT` mỗi 2 s (id, fw, rssi, heap, frames, chunks_fail). Root đưa `tree` và `nodes` vào telemetry. Log lỗi chunk giới hạn 1 dòng/s. Dashboard vẽ cây topology SVG, đánh dấu "firmware cũ?" và "mất tín hiệu". `FW_VERSION = 2026-09-29b` | Root + 3 Leaf |
| 4 | Leaf + Root | **RSSI đo từ phía AP** (`ap_rssi`) để nhánh hop 2 cũng có số đo. `FW_VERSION = 2026-09-30a` | Root + 3 Leaf |
| 5 | Root + dashboard | Thêm cột `lat_by_node` vào CSV; `link_rssi` tìm theo cả hai chiều liên kết. `FW_VERSION` Root = `2026-09-30b` | Chỉ Root |

Header CSV của test14 gồm: `time, leaf, fps, fpsPerNode, kbps, dropPct, chunksPs, frameKB, heapKB, latMs, latMinMs, latMaxMs, latN, hop_max, rssi_min_dbm, hop_by_node, rssi_by_node, lat_by_node`. Cuối file có thêm bảng `summary_leaf`.

### 3.2 Dashboard: đổi "leaf" → "drone" và đánh số drone (khoảng 01:09 → 01:20, ĐANG LÀM)

Chỉ sửa `thuattoan/middleware/public/dashboard.html`. Không đụng firmware, `server.js` hay giao thức UART. Không commit.

Yêu cầu đã giao cho Claude Code:
- Tab thứ 2 "So sánh 1/2/3 leaf" đổi thành **"Bảng so sánh"**.
- Mọi chữ "leaf" **hiển thị** trên giao diện đổi thành "drone", giữ kiểu viết hoa. **Giữ nguyên**: tên biến, khóa localStorage `meshDashCompare.v1`, field telemetry, event socket, comment, và **tên cột CSV**. Cột `leaf` được giữ để các file test1 → test14 vẫn ghép được với nhau.
- Badge góc phải "LEAF 3" đổi thành **"Tổng x Drone"**. Khi chưa có dữ liệu thì hiện "Tổng – Drone" màu xám.
- **Đánh số drone theo thứ tự kết nối** ("Drone 1", "Drone 2"…):
  - Bảng ánh xạ nodeId → số lưu trong localStorage, khóa mới `meshDashDroneOrder.v1`.
  - Drone mất kết nối rồi vào lại thì **giữ số cũ**. Không dồn số, không tái sử dụng số.
  - Nhiều node mới xuất hiện trong cùng một gói telemetry thì gán số theo thứ tự trong `node_ids`.
  - Có nút "Đánh số lại" ở panel Kết nối, bấm vào sẽ hỏi xác nhận.
  - Mọi chỗ hiển thị gọi chung một helper `droneLabel(nodeId)`. Node ID vẫn hiện ở dòng phụ, chữ nhỏ.
  - Card Media stream sắp xếp theo số drone.
- Kiểm thử hàm gán số bằng script Node tạm (6 kịch bản), chạy xong thì xoá script.

Prompt bổ sung (soạn sau khi có nhật ký 30/09, **chưa rõ đã gửi cho Claude Code hay chưa**):
- Cây topology SVG, bảng `nodes` và bảng `lat_by_node` cũng dùng `droneLabel`.
- Loại Root ID (2846999225) khỏi việc đánh số và khỏi badge. Số x của badge = số phần tử `node_ids` sau khi bỏ Root ID, dùng `node_count` nếu không có `node_ids`.
- **Không** sửa logic xếp nhóm của tab so sánh (vẫn theo `node_count`).
- Thêm 2 kịch bản test: Root có trong `node_ids`, và node chỉ xuất hiện trong `tree`/`nodes`.

Trạng thái: Claude Code đang chạy test (`test_drone_order.js`, test JSX) thì bị kẹt (mục 6). **Chưa có báo cáo kết quả.**

---

## 4. Diễn biến các lần đo

| File | Giờ VN | Cấu hình | Kết quả chính |
|---|---|---|---|
| test1.csv | ~10:49 | 300 ms (bản sửa chưa được nạp) | ~3.3 fps/Leaf; 2 Leaf đứng một lần; 1207369673 rớt sớm |
| test2.csv | ~11:12 | 600 ms, 1 Leaf | 1.67 fps, 7.8 KB/s, drop 0%, heap 113KB. **Mốc 1 Leaf** |
| test3.csv | ~11:20 | 600 ms, 3 Leaf | ~2 phút không đứng, 4.85 fps; một đợt drop 7–36% rồi tự hồi |
| TEST4-5P.csv | ~21:07 | 600 ms, 3 Leaf | 3 phút ổn định ~5 fps; sau đó các Leaf rớt lần lượt (nghi pin) |
| test5 | ~23:50 | Có latency, 1 → 2 Leaf | Latency 1 Leaf ~83 ms |
| test6.csv | ~00:01 | Lẫn firmware cũ và mới | **Không hợp lệ** (`Size mismatch`, đứng mạng) |
| test7.csv | ~00:06 | 2 Leaf | 3.33 fps, drop 0.35%, latency TB 242 ms |
| test9 | ~00:26 | Có topology, 1 → 2 Leaf | Luôn tạo chuỗi 2 hop; cây đảo chiều 1 lần (~13 s); nghẽn định kỳ ~54 s |
| test10.csv | ~00:43 | RSSI phía AP, 2 Leaf | Có RSSI hop 2; −55 đến −61 dBm vẫn giữ liên kết |
| test11 | ~00:48 | 3 Leaf, đủ firmware mới | 82 s, 5.02 fps, drop 0%, latency TB 177 ms |
| test12.csv | ~01:00 | Có `lat_by_node` | Hop 1 = 96.5 ms, hop 2 = 228 ms; Root tự đếm chính nó |
| **test13.csv** | **01:08 → 01:14** | **3 Leaf, 1 node hop 2** | **6 ph 14 s, drop 0% — kết quả dài nhất** |
| **test14.csv** | **01:25 → 01:30** | **3 Leaf, cả 3 hop 1** | **5 ph 2 s, không rớt node — xem mục 5.2** |

---

## 5. Kết quả chính

### 5.1 test13.csv — 3 Leaf, có 1 node hop 2

| Chỉ số | Giá trị |
|---|---|
| Thời gian chạy liên tục | 6 phút 14 giây (188 mẫu) |
| FPS tổng | 5.00 ± 0.59 (1.67 mỗi Leaf) |
| Thông lượng | 15.2 KB/s, 18.3 chunk/s |
| Tỉ lệ hủy frame | **0%** |
| Heap Root | 101.8KB (thấp nhất 96.2KB) |
| Latency TB | 208 ms |

Topology: 1207369673 và 1207449329 ở hop 1; 1207433521 ở hop 2.

| Node | Hop | RSSI TB | Latency trung vị | Latency TB | Lớn nhất |
|---|---|---|---|---|---|
| 1207369673 | 1 | −36 dBm | 110 ms | 114 ms | 227 ms |
| 1207449329 | 1 | −36 dBm | 193 ms | 188 ms | 388 ms |
| 1207433521 | 2 | −57 dBm | 256 ms | 312 ms | 2146 ms |

### 5.2 test14.csv — 3 Leaf, cả 3 cùng hop 1

18:25:01 → 18:30:04 UTC. 152 mẫu, không khoảng trống > 4 s. Suốt phiên luôn đủ 3 node và không có ID Root trong danh sách, tức lần này không có vòng liên kết.

| Chỉ số | Giá trị |
|---|---|
| Thời gian chạy liên tục | 5 phút 2 giây (152 mẫu) |
| FPS tổng | 4.99 ± 0.94 (1.66 mỗi Leaf) |
| Thông lượng | 16.1 KB/s, 17.3 chunk/s |
| Tỉ lệ hủy frame | TB 0.22%; 149/152 mẫu là 0%, có 3 mẫu lẻ 6–15% |
| Frame TB | 3.21 KB |
| Heap Root | TB 95.3KB (thấp nhất 80.6KB, lúc nghẽn) |
| Latency TB / trung vị | 205 ms / 140 ms |

Latency theo node, chỉ tính 137/152 mẫu không nghẽn (latency TB < 500 ms):

| Node | Hop | RSSI TB | Latency trung vị | P90 |
|---|---|---|---|---|
| 1207369673 | 1 | −36 dBm | 75 ms | 202 ms |
| 1207433521 | 1 | −52 dBm | 80 ms | 184 ms |
| 1207449329 | 1 | −35 dBm | 197 ms | 311 ms |

### 5.3 Nhận xét rút ra từ test13 và test14

**Hop 2 chậm hơn hop 1 khoảng 175 ms, đo trên cùng một board.** Node 1207433521 có latency trung vị 256 ms khi ở hop 2 (test13) và khoảng 80 ms khi ở hop 1 (test14). So sánh này chắc hơn cách so giữa hai node khác nhau trước đây. Tuy vậy đây là hai phiên riêng và topology tự hình thành, nên vẫn cần phép đo chuỗi hop có kiểm soát.

**Node 1207449329 chậm bất thường, không phải do relay.** Nhật ký bản trước đoán node này chậm vì phải relay cho 1207433521. Ở test14 không có relay, RSSI của nó tốt nhất, mà latency vẫn khoảng 200 ms, gấp hơn 2 lần hai node kia. Giả thuyết relay gần như bị loại. Nguyên nhân có thể nằm ở chính node đó (lệch đồng bộ `getNodeTime()`, hoặc chụp/mã hóa chậm hơn), **chưa kiểm chứng**.

**Nghẽn định kỳ khoảng 53 giây, lặp lại rất đều.** test14 có 5 đợt nghẽn quanh 18:25:42, 18:26:36, 18:27:34, 18:28:25 và 18:29:18 UTC, cách nhau 51–58 s. Mỗi đợt đi theo cùng một kiểu:
- FPS tụt về 1–2.5, rồi vọt lên 7–9.5 khi các frame dồn được xả ra.
- Latency TB lên 0.5–1.3 s; có frame tới 4.7 s.
- Heap Root sụt còn khoảng 81–84KB, rồi hồi lại ngay ở mẫu kế tiếp.

Chu kỳ khớp với test9/10/11 (50–54 s), nên nghi phạm quét WiFi định kỳ của painlessMesh càng đáng kiểm tra.

**Heap Root lúc bình thường ở test14 thấp hơn test13 khoảng 6KB** (95.6 so với 101.8KB). CSV không ghi phiên bản firmware nên chưa giải thích được.

### 5.4 Tổng hợp theo số Leaf (firmware mới, chu kỳ 600 ms)

| | 1 Leaf (test9) | 2 Leaf, chuỗi 2 hop (test9/10/12) | 3 Leaf có hop 2 (test13) | 3 Leaf cùng hop 1 (test14) |
|---|---|---|---|---|
| FPS tổng | 1.68 | 3.15–3.34 | 5.00 | 4.99 |
| Tỉ lệ hủy | 0% | 0–1.5% | 0% | 0.22% |
| Heap Root | ~108KB | ~106–108KB | ~102KB | ~95KB |
| Latency | nền ~55 ms | TB 162–243 ms | TB 208 ms | TB 205 ms, trung vị 140 ms |

### 5.5 So sánh trước và sau

| | 28/09 (300 ms, firmware 27/09) | 30/09 (600 ms, firmware mới) |
|---|---|---|
| 3 Leaf chạy được | 6–26 giây rồi đứng | 6 ph 14 s (test13), 5 ph 2 s (test14), không đứng |
| FPS tổng | ~10 (khi còn chạy) | ~5.0 |
| Heap Root | tụt xuống 57KB | 95–102KB, sụt ngắn xuống ~81KB lúc nghẽn |
| Tỉ lệ hủy | 0–5% lúc chạy, 100% khi đứng | 0–0.22% |

Cái giá của sự ổn định là FPS tổng giảm một nửa.

---

## 6. Sự cố gặp trong ngày và cách xử lý

**Bản sửa chu kỳ chụp không được áp dụng (sáng).** Lượt sửa lúc 10:43 không chạy vì Claude Code báo "Login expired", nên test1.csv vẫn đo trên firmware cũ. Đã đăng nhập lại và sửa xong lúc 11:09. Để kiểm tra Leaf đã chạy bản mới, xem Serial có dòng `[SYS] San sang! Chup moi 600 ms (~1.7 FPS)`.

**Lệch phiên bản firmware giữa Root và Leaf.** Root báo `[CHUNK] Size mismatch: decoded=1036, expected=1040`, lệch đúng 4 byte của `capture_us`. Nguyên nhân là 1207433521 chưa được nạp bản mới, làm hỏng test6. Cách xử lý:
- Giới hạn log lỗi 1 dòng/s.
- Leaf báo `fw` lên dashboard.
- Dashboard đánh dấu "firmware cũ?" cho node không gửi `#NSTAT`.

**Leaf rớt do pin.** Ở TEST4-5P, các Leaf rớt lần lượt sau nhiều giờ chạy pin. Ở test12, 1207449329 sáng đèn nhưng không vào mesh. Lưu ý: đèn đỏ trên ESP32-CAM chỉ báo có nguồn, không cho biết firmware có đang chạy. Sau khi xử lý nguồn, 3 Leaf chạy ổn định ở test13 và test14.

**Root tự xuất hiện trong danh sách node (test12).** Mesh báo 4 node, gồm cả Root 2846999225 ở hop 3, có vẻ do vòng liên kết. Hệ quả là `node_count` bị cộng thêm 1 và mẫu bị xếp nhầm nhóm. Lỗi không xuất hiện lại ở test13 và test14, nhưng **chưa sửa trong code**.

**Claude Code kẹt ở "Auto mode check unavailable" (~01:20).** Lỗi xảy ra khi Claude Code chạy test cho dashboard. Mô hình kiểm tra an toàn của auto mode không phản hồi, nên lệnh Bash bị giữ lại và thử lại tới 10 lần. Đây là lỗi phía công cụ, không phải lỗi code. Cách xử lý:
1. Bấm Esc để dừng vòng thử lại.
2. Bấm Shift+Tab để chuyển sang chế độ thường (duyệt từng lệnh). Không dùng bypass permissions.
3. Yêu cầu Claude Code chạy tiếp test đang dở.

Nếu vẫn lỗi, tự chạy lệnh `node ...` trong PowerShell rồi dán kết quả lại cho Claude Code.

---

## 7. Vấn đề còn tồn tại

1. **Nghẽn định kỳ khoảng 53 giây.** Đã lặp lại ở test9/10/11/13/14, kể cả khi chỉ có 1 Leaf. Mỗi đợt kéo latency lên tới vài giây và làm heap Root sụt ~15KB. Nghi do quét WiFi định kỳ của painlessMesh, **chưa xác nhận**.
2. **1207449329 có latency cao gấp đôi** hai node kia dù cùng hop 1 và RSSI tốt. Nguyên nhân chưa rõ.
3. **Root tự đếm chính nó** khi có vòng liên kết. Cần loại ID của Root khỏi `node_count`, `node_ids` và cây topology ở phía Root.
4. **Hệ thống ổn định nhờ giảm tải**, chưa phải nhờ sửa gốc. Các việc sau chưa làm: Root ghi UART không chặn, watchdog node treo, staggering bằng `getNodeTime()`.
5. **Chưa đo dòng tiêu thụ và thời gian chạy pin.**
6. **Topology hình thành ngẫu nhiên** (test13 có hop 2, test14 toàn hop 1). Chưa có phép đo theo số hop có kiểm soát.
7. **Dashboard đổi tên/đánh số drone chưa được xác nhận** (mục 3.2).

---

## 8. Việc tiếp theo

**Việc ngay khi quay lại:**
- [ ] Xem báo cáo của Claude Code về dashboard. Kiểm tra: không còn chữ "leaf" hiển thị, kết quả các kịch bản test đánh số, script tạm đã xoá, không có commit ngoài ý muốn.
- [ ] Nếu chưa gửi prompt bổ sung (cây topology, `lat_by_node`, loại Root ID), thì gửi.
- [ ] Mở dashboard với 3 Leaf. Xác nhận nhãn "Drone 1/2/3", badge "Tổng 3 Drone", và tắt/bật một Leaf xem số có được giữ nguyên không.
- [ ] Commit code hiện tại cùng CSV `test1`–`test14`, `TEST4-5P` và nhật ký này (đặt vào `nhatkylamviec/`).

**Việc kỹ thuật:**
- [ ] Bật log debug `CONNECTION` trên Serial của một Leaf, đối chiếu giờ log với các mốc nghẽn khoảng 53 s.
- [ ] Kiểm tra 1207449329: đổi vị trí với một Leaf khác, xem latency có đi theo board hay theo vị trí; xem log Serial.
- [ ] Loại ID của Root khỏi `node_count`, `node_ids` và cây topology ở firmware Root.
- [ ] Đo self-healing ít nhất 5 lần: tắt node đang làm relay, đo thời gian node hop 2 nối lại; ghi min/max/TB.
- [ ] Đo theo số hop có kiểm soát: chuỗi Root → A → B → C, liên kết khoảng −55 đến −70 dBm.
- [ ] Ghi phiên bản firmware Root vào mỗi lần đo (hoặc thêm cột `fw` vào CSV).
- [ ] Đo dòng tiêu thụ một Leaf khi truyền ảnh; ước tính thời gian chạy pin.
- [ ] Root ghi UART không chặn, watchdog, staggering, rồi thử giảm chu kỳ chụp về gần 300 ms.
- [ ] Viết mục FreeRTOS trong báo cáo, dùng lỗi Root quá tải làm ví dụ.

---

## 9. Đối chiếu với nhiệm vụ đồ án

| Nhiệm vụ | Tiến triển trong ngày |
|---|---|
| 2. Phần cứng, nguồn, độ ổn định | 3 Leaf chạy pin ổn định 5–6 phút liên tục (test13, test14); ghi nhận Leaf rớt do pin yếu |
| 3. Phân mảnh, ghép ảnh, mất chunk | Header 16 byte; tỉ lệ hủy 0–0.22% với 3 Leaf |
| 5. Dashboard | Có latency, cây topology, RSSI, phiên bản firmware; đang đổi hiển thị sang "drone" và đánh số drone |
| 6. Kịch bản thử nghiệm | Có số liệu theo số node (1/2/3), theo tải (300/600 ms), latency theo hop (1 và 2), và lần đầu so hop 1/hop 2 trên cùng một board |

---

## 10. Node ID tham chiếu

| Vai trò | Node ID |
|---|---|
| Root | 2846999225 |
| Leaf | 1207369673 |
| Leaf | 1207433521 |
| Leaf | 1207449329 |

---

## 11. Nguồn

- Số liệu: `test1.csv` → `test14.csv`, `TEST4-5P.csv`, CSV ngày 28/09.
- Nhật ký 29/09 → rạng sáng 30/09 (bản trước, được thay thế bởi file này).
- `claude_2026-09-29_cap-nhat-trang-thai-quyet-dinh-painlessmesh.md`: quyết định giữ painlessMesh, danh sách nhiệm vụ.
- `nhat-ky_2026-09-26_den_2026-09-27.md`: cấu trúc dashboard, khóa localStorage, các sự kiện socket.
- Prompt sửa dashboard và ảnh chụp Claude Code (khoảng 01:09 → 01:20 ngày 30/09).
