JoteraJ/do-an-chuyen-nganh-meshdrone/baocao/DoAn_WiFiMesh_LaTeX/frontmatter/camdoan.tex

% ================= LỜI CAM ĐOAN =================
\clearpage
\begin{center}
{\fontsize{16}{20}\selectfont\bfseries CÔNG TRÌNH ĐƯỢC HOÀN THÀNH\\ TẠI TRƯỜNG ĐẠI HỌC TÔN ĐỨC THẮNG\par}
\end{center}
\vspace{0.6cm}
Tôi xin cam đoan đây là công trình nghiên cứu của riêng tôi và được sự hướng dẫn khoa học của \gvhd. Các nội dung nghiên cứu, kết quả trong đề tài này là trung thực và chưa công bố dưới bất kỳ hình thức nào trước đây. Những số liệu trong các bảng biểu phục vụ cho việc phân tích, nhận xét, đánh giá được chính tác giả thu thập từ các nguồn khác nhau có ghi rõ trong phần tài liệu tham khảo.

Ngoài ra, trong \loaidoanthuong{} còn sử dụng một số nhận xét, đánh giá cũng như số liệu của các tác giả khác, cơ quan tổ chức khác đều có trích dẫn và chú thích nguồn gốc.

\textbf{Nếu phát hiện có bất kỳ sự gian lận nào tôi xin hoàn toàn chịu trách nhiệm về nội dung \loaidoanthuong{} của mình.} Trường Đại học Tôn Đức Thắng không liên quan đến những vi phạm tác quyền, bản quyền do tôi gây ra trong quá trình thực hiện (nếu có).

\vspace{0.8cm}
\hfill\begin{minipage}{0.55\textwidth}\centering
\textit{\ngayky}\\
\textit{Tác giả}\\
\textit{(ký tên và ghi rõ họ tên)}\\[2cm]
\textit{\tensinhvienthuong}
\end{minipage}
