JoteraJ/do-an-chuyen-nganh-meshdrone/baocao/DoAn_WiFiMesh_LaTeX/figures/chart_fps.png

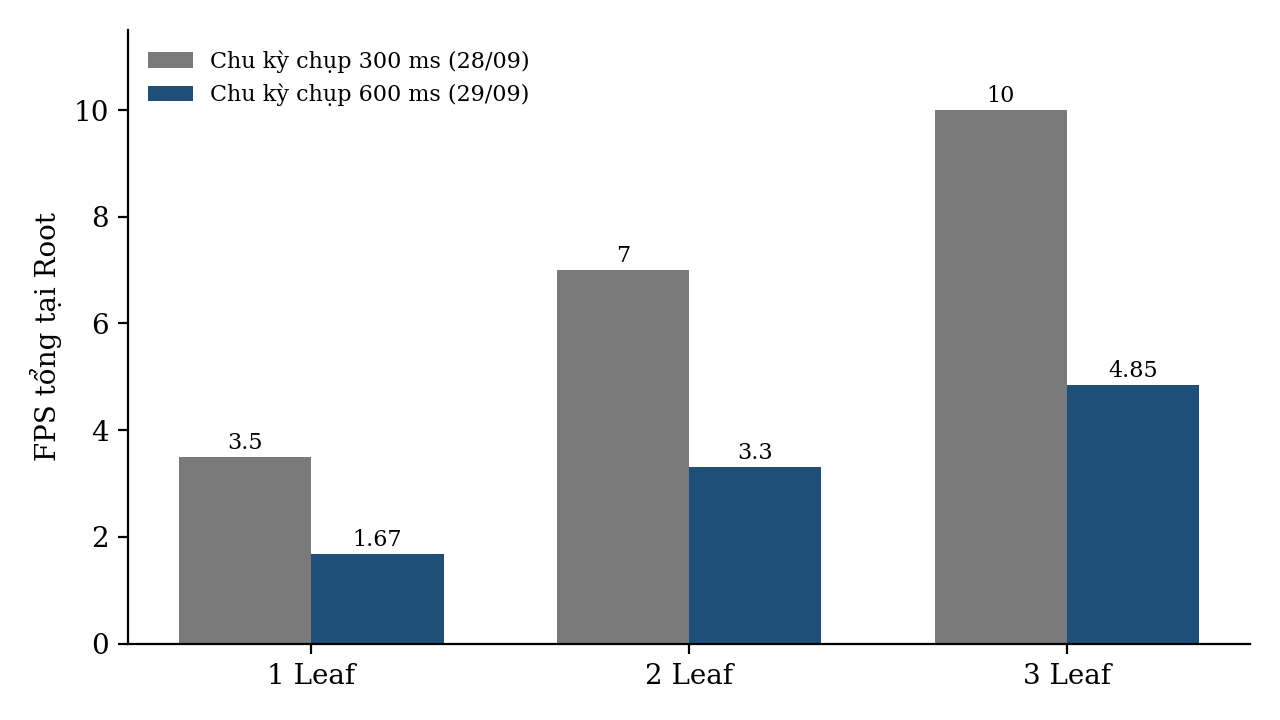
baocao/DoAn_WiFiMesh_LaTeX/figures/chart_fps.png
