JoteraJ/do-an-chuyen-nganh-meshdrone/docs/tài liệu/motagiaothuctruyen.png

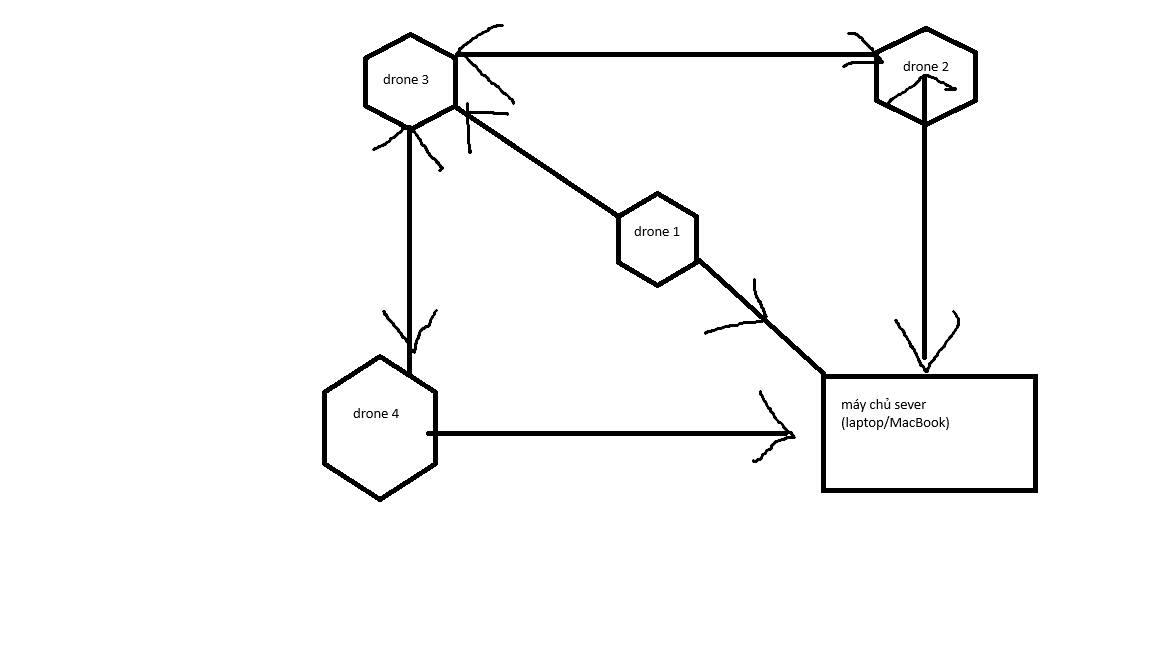
docs/tài liệu/motagiaothuctruyen.png
