JoteraJ/do-an-chuyen-nganh-meshdrone/data/2026-09-29/test1.csv

time | leaf | fps | fpsPerNode | kbps | dropPct | chunksPs | frameKB | heapKB
2026-09-29T03:49:29.038Z | 1 | 3.5000 | 3.5000 | 14.5015 | 0.0000 | 16.5000 | 4.1433 | 109.5742
2026-09-29T03:49:31.038Z | 1 | 3.5000 | 3.5000 | 14.4722 | 0.0000 | 17.5000 | 4.1349 | 111.1172
2026-09-29T03:49:33.038Z | 1 | 2.0000 | 2.0000 | 8.2979 | 0.0000 | 10.0000 | 4.1489 | 111.1172
2026-09-29T03:49:35.038Z | 1 | 4.5000 | 4.5000 | 19.0093 | 0.0000 | 22.5000 | 4.2243 | 111.1172
2026-09-29T03:49:37.037Z | 1 | 2.5000 | 2.5000 | 10.8985 | 0.0000 | 13.5000 | 4.3572 | 105.9727
2026-09-29T03:49:39.037Z | 1 | 0.0000 | 0.0000 | 0.0000 | 100.0000 | 0.0000 |  | 107.3555
2026-09-29T03:49:41.038Z | 1 | 5.5000 | 5.5000 | 23.1442 | 8.3333 | 30.5000 | 4.2101 | 104.5352
2026-09-29T03:49:43.038Z | 1 | 4.5000 | 4.5000 | 18.9697 | 0.0000 | 23.0000 | 4.2155 | 112.1484
2026-09-29T03:49:45.037Z | 1 | 3.5000 | 3.5000 | 14.6284 | 0.0000 | 16.5000 | 4.1775 | 110.0664
2026-09-29T03:49:49.084Z | 2 | 6.8393 | 3.4196 | 32.1512 | 0.0000 | 37.1275 | 4.7010 | 104.5781
2026-09-29T03:49:51.138Z | 2 | 6.3322 | 3.1661 | 31.5776 | 0.0000 | 36.0448 | 4.9893 | 85.8047
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
