JoteraJ/do-an-chuyen-nganh-meshdrone/data/2026-09-29/test2.csv

time | leaf | fps | fpsPerNode | kbps | dropPct | chunksPs | frameKB | heapKB
2026-09-29T04:12:50.691Z | 1 | 1.5000 | 1.5000 | 6.9878 | 0.0000 | 7.5000 | 4.6585 | 113.1953
2026-09-29T04:12:52.691Z | 1 | 2.0000 | 2.0000 | 9.3008 | 0.0000 | 10.0000 | 4.6504 | 113.1953
2026-09-29T04:12:54.690Z | 1 | 1.5000 | 1.5000 | 6.9913 | 0.0000 | 7.5000 | 4.6585 | 113.1953
2026-09-29T04:12:56.714Z | 1 | 1.9782 | 1.9782 | 9.1862 | 0.0000 | 9.8912 | 4.6482 | 113.1953
2026-09-29T04:12:58.712Z | 1 | 1.5000 | 1.5000 | 6.9723 | 0.0000 | 7.5000 | 4.6436 | 113.1953
2026-09-29T04:13:00.712Z | 1 | 1.5000 | 1.5000 | 6.9663 | 0.0000 | 7.5000 | 4.6442 | 113.0859
2026-09-29T04:13:02.712Z | 1 | 2.0000 | 2.0000 | 9.2974 | 0.0000 | 10.0000 | 4.6487 | 113.0859
2026-09-29T04:13:04.712Z | 1 | 0.5000 | 0.5000 | 2.3311 | 0.0000 | 2.5000 | 4.6621 | 112.9531
2026-09-29T04:13:06.712Z | 1 | 2.0000 | 2.0000 | 9.3003 | 0.0000 | 10.0000 | 4.6501 | 113.0859
2026-09-29T04:13:08.712Z | 1 | 2.5000 | 2.5000 | 11.6299 | 0.0000 | 12.5000 | 4.6520 | 113.0859
2026-09-29T04:13:10.711Z | 1 | 1.5000 | 1.5000 | 6.9727 | 0.0000 | 7.5000 | 4.6462 | 113.0859
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
