JoteraJ/do-an-chuyen-nganh-meshdrone/data/2026-09-29/test3.csv

time | leaf | fps | fpsPerNode | kbps | dropPct | chunksPs | frameKB | heapKB
2026-09-29T04:17:39.206Z | 1 | 1.5000 | 1.5000 | 15.3096 | 0.0000 | 10.5000 | 6.8740 | 111.6875
2026-09-29T04:17:41.205Z | 1 | 2.0000 | 2.0000 | 13.7549 | 0.0000 | 14.0000 | 6.8740 | 111.4805
2026-09-29T04:17:43.205Z | 1 | 1.5000 | 1.5000 | 10.3110 | 0.0000 | 10.5000 | 6.8740 | 111.6875
2026-09-29T04:17:45.205Z | 1 | 1.5000 | 1.5000 | 10.3110 | 0.0000 | 10.5000 | 6.8740 | 111.4531
2026-09-29T04:17:47.205Z | 1 | 2.0000 | 2.0000 | 13.7480 | 0.0000 | 14.0000 | 6.8740 | 111.4805
2026-09-29T04:17:49.205Z | 1 | 1.5000 | 1.5000 | 10.3110 | 0.0000 | 10.5000 | 6.8740 | 111.6875
2026-09-29T04:17:51.205Z | 1 | 1.5000 | 1.5000 | 10.3110 | 0.0000 | 10.5000 | 6.8740 | 111.5977
2026-09-29T04:17:53.212Z | 1 | 1.9930 | 1.9930 | 13.7001 | 0.0000 | 13.9512 | 6.8740 | 111.7383
2026-09-29T04:17:55.211Z | 1 | 1.5000 | 1.5000 | 10.3162 | 0.0000 | 10.5000 | 6.8740 | 111.9375
2026-09-29T04:17:57.212Z | 1 | 1.5000 | 1.5000 | 10.3059 | 0.0000 | 11.0000 | 6.8740 | 111.9531
2026-09-29T04:17:59.211Z | 1 | 1.5000 | 1.5000 | 8.5487 | 0.0000 | 11.0000 | 5.6963 | 111.7656
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
