JoteraJ/do-an-chuyen-nganh-meshdrone/data/2026-09-29/test5_firmque mới.csv

time | leaf | fps | fpsPerNode | kbps | dropPct | chunksPs | frameKB | heapKB | latMs | latMinMs | latMaxMs | latN
2026-09-29T16:50:13.054Z | 1 | 1.5000 | 1.5000 | 4.5317 | 0.0000 | 4.5000 | 2.8066 | 111.2031 | 69.5000 | 64.9000 | 75.9000 | 3.0000
2026-09-29T16:50:15.054Z | 1 | 2.0000 | 2.0000 | 5.6787 | 0.0000 | 6.0000 | 2.8394 | 111.2344 | 69.9000 | 61.8000 | 88.5000 | 4.0000
2026-09-29T16:50:17.054Z | 1 | 1.5000 | 1.5000 | 4.2495 | 0.0000 | 4.5000 | 2.8330 | 111.1211 | 69.9000 | 67.2000 | 73.9000 | 3.0000
2026-09-29T16:50:19.054Z | 1 | 1.5000 | 1.5000 | 4.2012 | 0.0000 | 4.5000 | 2.8008 | 111.2031 | 70.0000 | 66.5000 | 72.9000 | 3.0000
2026-09-29T16:50:21.079Z | 1 | 1.9753 | 1.9753 | 5.5691 | 0.0000 | 5.9259 | 2.8193 | 111.1563 | 127.1000 | 63.0000 | 266.2000 | 4.0000
2026-09-29T16:50:23.078Z | 1 | 1.5000 | 1.5000 | 4.1745 | 0.0000 | 4.5000 | 2.7816 | 111.2031 | 63.5000 | 61.3000 | 66.3000 | 3.0000
2026-09-29T16:50:25.078Z | 1 | 1.5000 | 1.5000 | 4.2476 | 0.0000 | 4.5000 | 2.8317 | 111.2031 | 155.3000 | 65.8000 | 333.1000 | 3.0000
2026-09-29T16:50:27.078Z | 1 | 2.0000 | 2.0000 | 5.5952 | 0.0000 | 6.0000 | 2.7976 | 111.0039 | 69.7000 | 62.8000 | 78.4000 | 4.0000
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
