JoteraJ/do-an-chuyen-nganh-meshdrone/data/2026-09-30/test10.csv

time | leaf | fps | fpsPerNode | kbps | dropPct | chunksPs | frameKB | heapKB | latMs | latMinMs | latMaxMs | latN | hop_max | rssi_min_dbm | hop_by_node | rssi_by_node
2026-09-29T17:42:53.571Z | 2 | 2.0000 | 1.0000 | 5.4658 | 0.0000 | 6.0000 | 2.7329 | 106.1133 | 222.9000 | 68.8000 | 497.2000 | 4.0000 | 2 | -39 | 1207369673:1;1207449329:2 | 1207369673:-39;1207449329:-29
2026-09-29T17:42:55.571Z | 2 | 5.5000 | 2.7500 | 15.0005 | 0.0000 | 16.5000 | 2.7274 | 106.0977 | 785.3000 | 65.4000 | 1911.8000 | 11.0000 | 2 | -39 | 1207369673:1;1207449329:2 | 1207369673:-39;1207449329:-30
2026-09-29T17:42:57.571Z | 2 | 3.5000 | 1.7500 | 9.6855 | 0.0000 | 10.5000 | 2.7673 | 106.1992 | 173.4000 | 62.3000 | 366.2000 | 7.0000 | 2 | -40 | 1207369673:1;1207449329:2 | 1207369673:-40;1207449329:-30
2026-09-29T17:42:59.570Z | 2 | 3.0000 | 1.5000 | 8.3010 | 0.0000 | 9.5000 | 2.7656 | 106.1992 | 75.5000 | 61.8000 | 94.9000 | 6.0000 | 2 | -39 | 1207369673:1;1207449329:2 | 1207369673:-39;1207449329:-30
2026-09-29T17:43:01.596Z | 2 | 3.4585 | 1.7292 | 8.0651 | 0.0000 | 9.8814 | 2.7233 | 106.1836 | 154.3000 | 65.1000 | 274.2000 | 7.0000 | 2 | -40 | 1207369673:1;1207449329:2 | 1207369673:-40;1207449329:-29
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
