JoteraJ/do-an-chuyen-nganh-meshdrone/firmware/node_root/secrets.example.h

/* secrets.h — mau. Copy thanh secrets.h va dien SSID/mat khau router.
 *  File nay KHONG commit (.gitignore da chan moi secrets.h trong thuattoan/).
 *  Tao bang cach copy secrets.example.h -> secrets.h roi dien gia tri that.
 */
#ifndef SECRETS_H
#define SECRETS_H

#define STATION_SSID       "YOUR_WIFI_SSID"
#define STATION_PASSWORD   "YOUR_WIFI_PASSWORD"

#endif // SECRETS_H
