JoteraJ/do-an-chuyen-nganh-meshdrone/(commit log)

2026-09-16 Bring-up Leaf2/Leaf3, chan doan tranh chap RF, ke hoach nguon pin doc lap
2026-09-30 Firmware do latency, topology va RSSI (29-30/09)
    - Header chunk 16 B them capture_us; CAPTURE_INTERVAL_MS Leaf = 600
    - Leaf: beacon #ROOT, gui #NSTAT (fw, rssi, heap, frames, ap_rssi)
    - Root: telemetry latency/topology/RSSI, FW_VERSION
    - UART_PROTOCOL.md: sua MAX_FRAME_SIZE = 24576 cho khop code
    - node_root/mesh_config.h: bo CAPTURE_INTERVAL_MS (Root khong dung)
2026-09-30 Root theo doi node im lang va bao ve heap
    - node_track[8] (mang tinh): last_chunk_ms cap nhat moi chunk hop le,
    in_list/seen_ms tu getNodeList() (changedConnectionCallback + moi 500 ms)
    - silent = con trong mesh nhung qua SILENT_NODE_MS (10000) khong co chunk;
    dem silent_events khi mot node chuyen sang im lang
    - nodes[] them last_chunk_age_ms, silent, rst, up_s (rst/up_s tu NSTAT,
    null neu Leaf firmware cu)
    - Heap < HEAP_CRITICAL_BYTES (40960) lien tuc qua HEAP_CRITICAL_MS
    (10000) -> khung LOG roi ESP.restart(); log ly do reset Root luc khoi dong
    [mesh_config.h, node_root.ino]
2026-09-30 Do self-healing theo luong du lieu tung node (heal_events)
    - Root: moc bat dau = luc node bien khoi getNodeList() (start_src "list",
    bat trong changedConnectionCallback + moi 500 ms); khong bat duoc thi
    dung last_chunk_ms khi khoang trong > SILENT_NODE_MS ("last_chunk").
    Ket thuc = chunk hop le dau tien sau su co. Giu last_self_heal_ms cu
    - Telemetry heal_events[] toi da 8 muc {id, ms, start_src, ts}, moi muc
    chi gui 1 lan roi xoa
    - Dashboard: tab So sanh dung so do moi (n, mean, sd, min, max), giu dong
    cach cu; CSV summary heal_ms_moi/heal_ms_cu + bang tung su kien; loc
    trung theo id:ts; cay topology to node silent (vien do net dut), hien
    rst va up_s
    - UART_PROTOCOL.md 4.2: mo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
2026-09-30 Root ghi UART khong chan: TX buffer 8192, bo frame anh khi buffer day
    - Serial.setTxBufferSize(UART_TX_BUFFER_SIZE = 8192) truoc Serial.begin()
    (ESP32 Arduino core 2.0.17 co ham nay); log heap truoc/sau Serial.begin
    - send_image_frame(): TX buffer con trong < mot nua -> bo frame anh,
    tang uart_drop; TELEMETRY va LOG khong bao gio bi bo. setTxBufferSize
    that bai thi giu ghi chan nhu cu
    - Telemetry + dashboard + CSV them uart_drop; UART_PROTOCOL.md 4.2
2026-09-30 Staggering lich chup Leaf theo dong ho mesh (co co bat/tat)
    - mesh_config.h: STAGGER_ENABLE 1, STAGGER_SLOTS 3, bang slot co dinh
    1207433521 -> 0, 1207449329 -> 1, 1207369673 -> 2 (khong dung
    node_id % 3 vi 2 node cung ra 2); node ngoai bang dung node_id % 3
    - Chup tai moc k*P + slot*P/3 theo mesh.getNodeTime(), P = 600 ms
    - Xu ly wrap uint32 bang phep tru co dau; dong ho mesh nhay toi/lui qua
    1 chu ky -> chup ngay 1 lan roi bam lich moi, khong chup don
    - STAGGER_ENABLE 0 -> giu lich millis() cu de do A/B
2026-09-30 chore: chuyen du lieu do va esp_idf_migration vao data/
    - thuattoan/esp_idf_migration, thuattoan/shared, thuattoan/.gitignore -> data/
    - leaf1_log.txt -> data/serial-logs/
    - CSV test mo phong xep theo ngay: data/2026-09-29/, data/2026-09-30/
    [TEST4-5P.csv, test1.csv, test10.csv, test11_newfirmware_3leaf.csv, test12.csv, test13.csv, test14.csv, test15-newfirmware.csv]
2026-09-30 chore: chuyen nhat ky, tai lieu, UART_PROTOCOL vao docs/
    - nhatkylamviec/ -> docs/nhatkylamviec/
    - tai lieu/ -> docs/tai lieu/
    - thuattoan/UART_PROTOCOL.md -> docs/
    - prompt_bringup_3_leaf_camera_node.md -> docs/nhat-ky/
2026-09-30 fix(root): tuoi "im lang" khong con tran so 4294967295 ms
    - update_node_tracking()/on_valid_chunk(): moi luot chi goi millis() 1 lan,
    truyen now vao track_find() nen seen_ms khong bao gio sau now (test15).
    - age_ms(): tuoi an toan (ref sau now -> 0), dung cho silent, heal, last_chunk_age_ms,
    age_ms NSTAT, ap_links_of, NSTAT_FORGET, cleanup_stale_frames.
    - An han SILENT_NODE_MS tu seen_ms cho node moi (lai) vao mesh (ghi ro trong code).
    - Leaf check_root_watchdog(): chan since am (phong xa, tranh restart nham).
    - firmware/tools/test_millis_age.py: tai hien -1 o thu tu cu, chung minh da het.
    [node_camera.ino, node_root.ino]
2026-09-30 fix(root): tat HTTP server tren Root (HTTP_ENABLE 0)
    - mesh_config.h: co HTTP_ENABLE (mac dinh 0).
    - node_root.ino: boc #if HTTP_ENABLE (khong xoa) cho bien HTTP, latest_frame,
    cac ham serve_html_page/send_mjpeg_frame/handle_http_clients, httpServer.begin(),
    khoi in IP trong loop() va handle_http_clients().
    - Log khoi dong: "[SYS] HTTP: TAT | Heap truoc/sau khoi HTTP: ...".
    - Khong con in STATION_SSID (secrets.h) ra log ca khi HTTP_ENABLE 1.
    [mesh_config.h, node_root.ino]
2026-09-30 fix(root): telemetry/LOG khong chan loop khi UART TX day
    - send_uart_frame() tra bool; uart_room_for(): chi ghi khi TX buffer du cho ca
    khung (+ du phong item ring buffer NOSPLIT), khong thi KHONG ghi byte nao.
    - TELEMETRY: hoan, uart_defer +1 moi khung, thu lai o vong loop sau voi JSON
    moi nhat (khong xep hang). heal_events va mau latency chi xoa sau khi khung
    da thuc su ghi.
    - LOG: bo khi day, dem log_drop.
    - uart_tx_buf_size == 0 (setTxBufferSize that bai) hoac khung lon hon kha nang
    buffer: giu hanh vi cu (ghi chan).
    - Heap guard: Serial.flush() truoc dong ly do restart.
    - Telemetry + [STAT]: them uart_defer, log_drop.
    [node_root.ino]
2026-09-30 feat(root): do dac tim nguyen nhan reset (loop_max, heap_min, WDT boot log)
    Chi them do dac, khong doi cau hinh WDT (khong esp_task_wdt_add).
    - loop_max_ms: vong loop() lau nhat trong cua so telemetry, reset sau moi lan gui.
    - heap_min_win: esp_get_free_heap_size() thap nhat trong cua so; heap_min_boot = ESP.getMinFreeHeap().
    - rx_q: null - painlessMesh giu receiveBuffer/sentBuffer o protected, khong co API
    doc (getQueuedMessageCount() chi dem messageQueue tuy chon, mac dinh nullptr).
    - diag_noinit (__NOINIT_ATTR): loop_max, heap cuoi, heap_min_win, uptime, stage
    (buoc loop() dang chay) ghi moi vong loop(); reset_reason 5/6/7 -> khung LOG
    "[BOOT] WDT reset ..." ngay luc khoi dong.
    - Da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
    [node_root.ino]
2026-09-30 feat(middleware): ghi byte UART tho ngoai khung ra data/raw/
    - protocol.js: FrameParser nhan opts.onSkip(buf, reason) - chi quan sat, bao moi
    byte khong thuoc khung hop le ('skip': rac/LEN vo ly, 'crc': ca khung sai CRC).
    Duong tach khung va stats khong doi.
    - raw_logger.js: data/raw/uart_raw_YYYYMMDD_HHMMSS.log, moi dong co moc thoi gian,
    ASCII giu nguyen, byte khac \xNN; ghi dia moi 1 s; xoay file o 20 MB.
    - server.js: noi RawLogger vao parser, in duong dan file, /status co rawLog.
    - test_raw_logger.js (5/5): dong WDT giua 2 khung va chen giua khung anh (sai CRC)
    deu vao file; test_protocol.js van 8/8.
    - .gitignore: data/raw/.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
2026-09-30 feat(middleware): CSV them fw_root, fw_leaf, stagger, n_leaf va truong do moi
    - Leaf #NSTAT them "stg" (STAGGER_ENABLE); Root luu va dua "stg" vao nodes[]
    (Leaf fw cu -> null).
    - CSV: cot so uartDefer, logDrop, loopMaxMs, heapMinWinKB, heapMinBootKB;
    cot chuoi n_leaf (Leaf con trong cay dang gui NSTAT), fw_root, fw_leaf
    ("id:fw;..."), stagger (1/0/mix).
    - Khong co dup_slot_events (Muc 2 dung) va skip (Muc 6 dung).
    [node_camera.ino, node_root.ino]
2026-09-30 chore: luu CameraNode.ino ban dau vao archive/camera_node_v0/
    Khoi phuc tu HEAD va chuyen (R100) "code esp32/CameraNode/CameraNode.ino"
    -> archive/camera_node_v0/CameraNode.ino, khong xoa khoi lich su.
2026-09-30 fix(root): bo chunk tre cua frame da dong, khong mo slot, khong SUPERSEDE
    Nguyen nhan (test15, node 1207369673 frame 193 o 2 slot 4/5 roi 1/5): chunk
    cuoi toi SAU khi slot da dong (SUPERSEDE/TIMEOUT) -> Root khong nho frame da
    dong, mo slot moi cho 193 va SUPERSEDE luon frame 194 dang ghep.
    - asm_hist[8] (mang tinh): moi node nho frame_id moi nhat da mo slot va da
    dong chua; cap nhat o moi cho dong slot (xong, SUPERSEDE, TIMEOUT, EVICTION).
    - is_late_chunk(): frame cu hon 1..16 (so sanh int16_t, dung qua 65535->0) hoac
    dung frame moi nhat da dong, trong 2 x REASSEMBLY_TIMEOUT_MS -> bo, dem
    late_chunk_drop. Het cua so -> nhan binh thuong (Leaf reset frame_id ve 0).
    - Telemetry "late_ch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
    [node_root.ino]
2026-09-30 docs(protocol): bo sung truong moi Root/Leaf 2026-10-01a vao UART_PROTOCOL.md
    - TELEMETRY: uart_defer, log_drop (Muc 4), late_chunk_drop (Muc 2), loop_max_ms,
    heap_min_win, heap_min_boot, rx_q (Muc 5), nodes[].stg (Muc 8).
    - Sua mo ta cu "TELEMETRY va LOG khong bao gio bi bo": nay khong chan loop,
    TELEMETRY hoan/dung lai, LOG bo khi TX day.
    - #NSTAT them "stg"; LOG khoi dong "[SYS] HTTP: TAT", "[BOOT] WDT reset" + y nghia stage.
    - Muc 7: byte ngoai khung ghi vao data/raw/ (raw_logger.js).
    - Duong dan moi (archive/, firmware/tools/), HTTP_ENABLE 0.
2026-10-01 chore(data): them test17.csv vao data/2026-09-30 (test chay 23:33 gio VN 30/09)
    [test17.csv]
2026-10-01 fix(root): heap guard do heap DEFAULT, nguong HEAP_DEF_CRITICAL_BYTES 16384
    Guard cu do ESP.getFreeHeap() (INTERNAL, cao hon DEFAULT ~47 KB) voi nguong
    40960: DEFAULT phai gan ve 0 guard moi thay. Nay do esp_get_free_heap_size()
    (cung phep do voi heap_def_min_win), nguong 16384, giu HEAP_CRITICAL_MS 10 s.
    test17: heap_def_min_win thap nhat 25.2 KB, khong cua so nao < 16 KB ->
    guard moi khong kich hoat.
    [mesh_config.h, node_root.ino]
2026-10-01 feat(root): telemetry frame_max_bytes_win/boot (frame lon nhat Root ghep xong)
    Do kich thuoc JPEG lon nhat Root ghep xong trong cua so telemetry va tu luc
    khoi dong, de quyet dinh co giam MAX_FRAME_SIZE (24576) duoc khong. Chua doi
    MAX_FRAME_SIZE hay so slot. Dashboard: cot CSV frameMaxBytesWin/Boot.
2026-10-01 docs: bao cao lan 3 — heap INTERNAL/DEFAULT, bien an toan, phan tich giam slot
    BAO_CAO_FIX_2026-10-01.md them Muc 9-12 (doi ten truong heap, guard DEFAULT,
    frame_max_bytes, phan tich giam slot 24576 -> 12288 chua sua) va muc bien an
    toan heap tu test17; cap nhat bang truong telemetry, danh sach commit,
    checklist (FW 2026-10-01b, thay tieu chi heap_min_win > 70 KB).
    UART_PROTOCOL.md: ghi ro Root khong co PSRAM kha dung (psram_free = 0).
2026-10-01 feat(fw): giam slot ghep anh 24576 -> 12288 B (Root + Leaf), giu 4 slot
    test18: frame lon nhat 5887 B (frame_max_bytes_boot), heap DEFAULT day 21.4 KB.
    MAX_FRAME_SIZE 12288, MAX_CHUNKS_PER_FRAME 12 o ca Root va Leaf (Leaf bo frame
    lon hon truoc khi gui). 4 buffer ghep cap tu heap DEFAULT -> tiet kiem
    4 x 12288 = 48 KB. Log khoi dong [MEM]/[SYS] in them heap DEFAULT de doi chieu.
    UART_PROTOCOL.md: cap nhat MAX_FRAME_SIZE va dong log.
2026-10-01 feat(leaf): dem frame bo vi qua MAX_FRAME_SIZE, gui "big" trong #NSTAT
    Sau khi giam MAX_FRAME_SIZE xuong 12288, Leaf bo frame lon hon truoc khi gui.
    Dem so frame nay (frames_too_big) va gui "big":N trong #NSTAT. Root luu va
    dua vao telemetry nodes[].big (null = Leaf fw cu). Dashboard hien "qua co N"
    theo node va trong tooltip cay mesh; CSV them cot big_by_node ("id:N;...").
2026-10-01 fix(root): bo anh o UART khi TX buffer khong du ca khung (thay nguong nua buffer)
    Dieu kien cu: availableForWrite < buf/2 (4096) -> frame lon hon phan trong
    van duoc ghi va Serial.write() cho toi khi phan du ra day. Nay bo frame khi
    availableForWrite < 7 + 10 + jpeg_len + 2 (ca khung). JPEG > 8173 B (buffer
    8192) vi vay luon bi bo. Giu nguyen nhanh ghi chan khi khong co TX buffer.
    [mesh_config.h, node_root.ino]
2026-10-01 chore(data): them test18.csv (2 Leaf, 6 phut, Root 2026-10-01b)
    [test18.csv]
2026-10-01 docs: bao cao lan 4 — test18, giam slot, heap khoi dong
    BAO_CAO_FIX_2026-10-01.md them Muc 13-17: so lieu test18, giam slot 12288,
    "big" o Leaf, dieu kien bo anh UART moi (va cho ngan con lai do ring buffer),
    FW Root 2026-10-01c / Leaf 2026-10-01b, heap DEFAULT luc khoi dong truoc/sau
    (du kien — chua co log khoi dong that vi middleware khong luu khung LOG).
    Cap nhat bang truong telemetry, danh sach commit, checklist.
2026-10-06 Root: UART TX buffer 16KB
2026-10-12 Cap nhat bao cao LaTeX, du lieu do 06-10 va 09-10, nhat ky
    [test19.csv, test20.csv, test21.csv, test22.csv]
